feliksdd/panellog/hardware/kicad/ERC_DRC_REVIEW_2026-10-29_2241.md

# PanelLog: KiCad 10 ERC/DRC follow-up — 2026-10-29 22:41

## Source reports

- Uploaded `panellog-erc-aktuell.rpt` (2026-10-29T22:41:49): **0 errors, 3 warnings** of type `same_local_global_label`. Flags added in the previous commit had been connected with local labels `VDC`, `GND` and `+3V3`, which KiCad flags because those are already implicit global power-symbol nets.
- Uploaded `panellog-pcb-drc-aktuell.rpt` (2026-10-29T22:41:55): **39 DRC footprint-library warnings**, **131 unrouted pads/connections**, **2 PCB/schematic field differences**. Crucially, **0 reported `shorting_items`, 0 `solder_mask_bridge`, and 0 `net_conflict`**. This is a significant improvement compared with the previous DRC, which had 7+7+6 violations respectively.

These counts describe the attached **pre-fix** reports, NOT a native KiCad run after the changes below.

## Corrections made for this report

1. Removed three redundant local labels at the Power Flag block (VDC/GND/+3V3).
2. Added **actual KiCad `power:VDC`, `power:GND`, `power:+3V3` symbol instances**, references `#PWR036`–`#PWR038`, each connected with a short straight `wire` to the existing `power:PWR_FLAG` instance. The power symbols' global connectivity is explicit, rather than relying on a local net label matching a global power symbol. Neither board components nor circuit topology change.
3. Fixed two PCB footprint metadata mismatches: RSH1 Datasheet now equals the schematic's Isabellenhütte BVB URL and Y1 Description now equals the schematic field "Two pin crystal". Do not treat PCB metadata synchronization as footprint-geometry verification.

## Remaining work

### 39 `lib_footprint_mismatch` warnings

The board's 39 footprint *instances* differ from their linked KiCad/PanelLog library copies. Most were generated in the placement draft and use approximated artwork/courtyard/pad and assembly information. **Do not disable this check to pass DRC.** For standard, manufacturer-qualified resistor/capacitor/diode/SOT-23/crystal footprints, use KiCad 10 PCB editor → **Tools → Update Footprints from Library…** selectively, reviewing rotations, pads and existing net assignments. For project-specific `*_DRAFT` footprints (BVB Kelvin, Infineon TOLL, E73, LM5164 DDA, provisional L1/MC4), first validate the manufacturer's physical land-pattern, paste, mask, pad numbering and RF/mechanical keepouts; only then synchronize the schematic and board.

### 131 unconnected items

The board is *almost entirely unrouted*, so these messages are expected but represent real electrical incompleteness. The 9-mm PV+ and 5-mm SHUNT_RETURN study segments have not been validated for 20 A, no full low-side return or Kelvin routing exists, and there is no valid RF copper keepout. Complete the placement/footprints and current paths before attempting other routing or Gerber fabrication.

### Native checks to run again

```bash
git pull --ff-only
flatpak run --command=kicad-cli org.kicad.KiCad sch erc \
  hardware/kicad/panellog.kicad_sch -o panellog-erc-next.rpt
flatpak run --command=kicad-cli org.kicad.KiCad pcb drc \
  --schematic-parity --severity-all \
  -o panellog-pcb-drc-next.rpt hardware/kicad/panellog.kicad_pcb
```

Expected outcome of the next run: the three duplicate-label ERC warnings and two PCB field mismatches should be gone; 39 library mismatch messages and the unrouted connections will persist until explicitly resolved. If any newly introduced ERC or DRC issue appears, analyze the concrete report rather than suppress it.

**Release status remains: NOT FOR FABRICATION.**
