feliksdd/panellog/hardware/kicad/review_2026-11-04/back.png

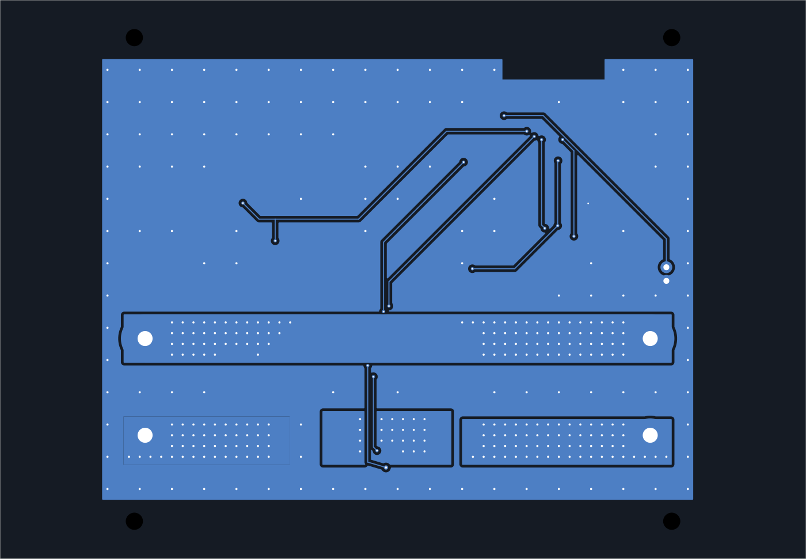
hardware/kicad/review_2026-11-04/back.png
