feliksdd/panellog/hardware/kicad/review_2026-11-04/front.png

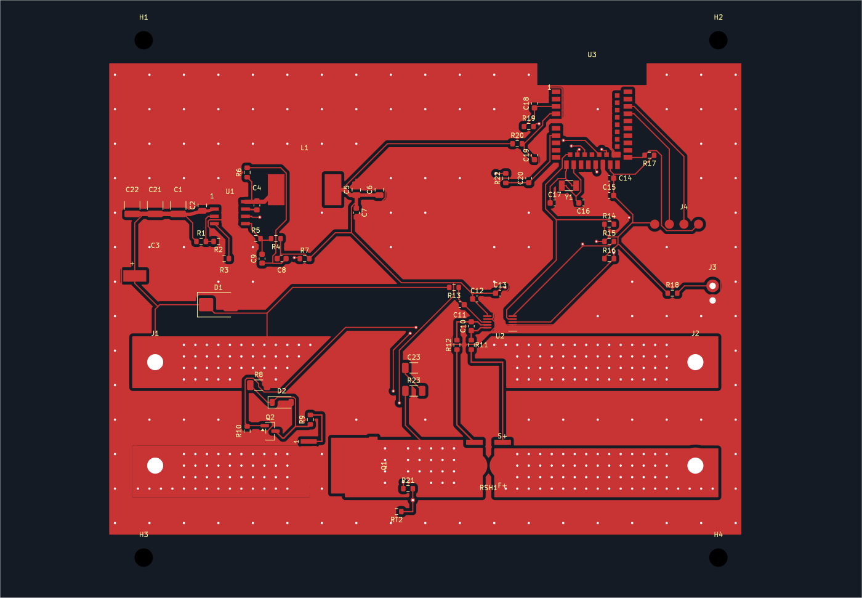
hardware/kicad/review_2026-11-04/front.png
