feliksdd/panellog/docs/bom_costs_2026-11-08.md

# PanelLog BOM availability and cost audit — 2026-11-08

Based on GitHub a25bd26 plus Sumida L1 replacement. Public LCSC USD catalogue
prices and stock were retrieved directly from product-page structured data.
Per-part quantities, MOQ, order multiple, price tiers, stock, timestamp and URL
are saved in bom/panellog_costs_2026-11-08.csv and lcsc_audit_2026-11-08.json.

## Result

59 fitted PCB components, 33 distinct PCB order codes; external Pt1000 adds
one part and one code. All purchased, selected components now have an exact
LCSC number. 32 of 33 PCB order codes and the external sensor are in stock
in quantities sufficient for four boards and their MOQ. **R18 remains out of
stock. A complete orderable final BOM price cannot yet be confirmed.**

| Scope | Fitted parts, one-board batch | Fitted parts, four-board batch | Purchase incl. MOQ, one board | Purchase incl. MOQ, four boards |
|---|---:|---:|---:|---:|
| PCB components incl. R18 reference price | $14.3677 | $56.3860 ($14.0965/board) | $26.4805 | $65.2717 |
| External bare Pt1000 | $2.6957 | $10.7828 | $2.6957 | $10.7828 |
| Combined, incl. unavailable R18 reference price | $17.0634 | $67.1688 | $29.1762 | $76.0545 |

These totals exclude PCB fabrication, assembly, component attrition,
shipping, taxes, customs, enclosure, cables and sealing. MOQ calculations
use the catalogue minimum and order multiple, NOT the full-reel quantity.
The first available price tier is used below MOQ for fitted-cost allocation.
Four-board demand is aggregated across identical order codes before pricing.
Stocked items only cost $64.2821 for PCB parts, or $75.0649 including four bare
Pt1000 elements. **These subtotals omit R18 and are not a complete BOM.**
No order was placed. Checkout rounding and stock/price changes can alter totals.

## Changes and sourcing gaps

- L1: CDRH127/LDNP-680MC, C2452974, stock 5,871, $0.7122 at quantity 1–9.
  Schematic, footprint and board updated; see sumida_l1_2026-11-08.md.
- C7/C10/C12/C14/C18/C19/C20/C25: C14663 has stock zero. Replaced with
  Samsung CL10B104KB8NNNC, C1591: same 100 nF, 50 V, X7R, ±10%, 0603.
  Stock 1,668,800, MOQ/multiple 100, $0.0072 at 100. Eight fitted per board.
- RT1: exact bare YAGEO/Nexensos 32208572 = C17472362, stock 214,
  $2.6957 each. This is NOT a weatherproof cabled probe. Manufacturer lifecycle
  information marks it not for new design; existing design retained.
- R18: RG1608N-1472-W-T1, C1721340, stock zero. Listed $0.2474 is a
  reference price only. Checked W-T5, P-W-T1 and N-B-T5 variants also lack stock.
  C2074591 (Panasonic ERA-3AEB1472V) has stock 925, MOQ 5, $0.0804 each,
  but is ±0.1% / ±25 ppm/K instead of ±0.05% / ±10 ppm/K. Same resistance and
  0603 footprint, but **not substituted**. Approximate extra Pt1000 reference
  error at 25 °C: 0.13 K initial and 0.195 K after a 50 K board temperature
  change (first-order 3850 ppm/K model); calibration can remove initial ratio
  error, not uncharacterized temperature drift. If approved, the four-board
  purchase total including sensor would be $75.4669, still excluding mechanics.

## Non-purchased PCB features and external assembly

J1 is absent from the current design and marked removed. Current power pads
are J2/J6 (VDC), J5 (MPPT_MINUS), J7 (GND). J3 is the sensor cable solder pad;
J4 consists of programming pogo lands. H1–H4 are drilled mounting holes.
They have no separate LCSC order number and zero purchased-component quantity.
Do not buy four fictitious connector bodies from these PCB references.

External PV leads, compatible connector pairs, sensor cable/encapsulation,
cable glands, enclosure and spacers remain mechanically unspecified. No
arbitrary LCSC part is assigned without wire size, cable length, mating system
and enclosure interface. Their cost is **not included and not finalized**.
C16/C17/Y1 are removed; C23/D1/R23 are DNP and excluded. DNP snubber/TVS values
must follow transient qualification rather than being selected to fill a BOM cell.

## Deliverables and checks

- panellog_rev0_selection.csv: one line per reference, including explicit
  non-orderable PCB features, DNP and removed references.
- panellog_c6_procurement_4boards.csv: consolidated selected component demand,
  including RT1 and the blocked R18.
- LCSC_import_4boards_in_stock.csv: MOQ-rounded import for stocked lines only.
  **R18 intentionally missing; this import does not complete four boards.**
- panellog_costs_2026-11-08.csv: full costing and availability, USD.

Native KiCad final checks: 43 existing open connections, zero parity issues,
five existing ERC findings. No new electrical DRC errors. Not ready for manufacture.
