feliksdd/panellog/bom/panellog_c6_procurement_4boards.csv

References | Value | MPN | LCSC | Footprint | Qty_per_board | Qty_4_boards
C1 C21 C22 | 4.7uF 100V X7R | 1210B475K101NT | C7500895 | Capacitor_SMD:C_1210_3225Metric | 3 | 12
C2 | 100nF 100V X7R | CL21B104KCFNNNE | C28233 | Capacitor_SMD:C_0805_2012Metric | 1 | 4
C3 | 10uF 100V EEEFN2A100P | EEEFN2A100P | C494873 | PanelLog:Panasonic_F_8x10p2 | 1 | 4
C4 | 2.2nF 50V X7R | 0603B222K500NT | C1604 | Capacitor_SMD:C_0603_1608Metric | 1 | 4
C5 C6 C15 | 22uF 25V X5R | CL21A226MAQNNNE | C45783 | Capacitor_SMD:C_0805_2012Metric | 3 | 12
C7 C10 C12 C14 C18 C19 C20 C25 | 100nF 50V X7R | CC0603KRX7R9BB104 | C14663 | Capacitor_SMD:C_0603_1608Metric | 8 | 32
C8 | 3.3nF 50V X7R | CL10B332KB8NNNC | C1613 | Capacitor_SMD:C_0603_1608Metric | 1 | 4
C9 | 150pF 50V C0G | CL10C151JB8NNNC | C37298 | Capacitor_SMD:C_0603_1608Metric | 1 | 4
C11 | 10nF 100V X7R | CC0603KRX7R0BB103 | C107059 | Capacitor_SMD:C_0603_1608Metric | 1 | 4
C13 C24 | 1uF 50V X5R | CL10A105KB8NNNC | C15849 | Capacitor_SMD:C_0603_1608Metric | 2 | 8
D2 | MMSZ4697 10V C2910058 | MMSZ4697 | C2910058 | Diode_SMD:D_SOD-123 | 1 | 4
L1 | 68uH CDRH127/LDNP-680MC | CDRH127/LDNP-680MC | C2452974 | PanelLog:Sumida_CDRH127_LD_68uH | 1 | 4
Q1 | IPT015N10N5 | IPT015N10N5 | C108964 | PanelLog:IPT015N10N5_TOLL | 1 | 4
Q2 | 2N7002 | 2N7002 | C8545 | Package_TO_SOT_SMD:SOT-23 | 1 | 4
R1 | 1M 1% | 0603WAF1004T5E | C22935 | Resistor_SMD:R_0603_1608Metric | 1 | 4
R2 | 200k 1% | 0603WAF2003T5E | C25811 | Resistor_SMD:R_0603_1608Metric | 1 | 4
R3 R29 | 27.4k 1% | 0603WAF2742T5E | C22964 | Resistor_SMD:R_0603_1608Metric | 2 | 8
R4 | 174k 1% | 0603WAF1743T5E | C22890 | Resistor_SMD:R_0603_1608Metric | 1 | 4
R5 R10 R20 R24 | 100k 1% | 0603WAF1003T5E | C25803 | Resistor_SMD:R_0603_1608Metric | 4 | 16
R6 | 150k 1% | 0603WAF1503T5E | C22807 | Resistor_SMD:R_0603_1608Metric | 1 | 4
R7 | 47k 1% | 0603WAF4702T5E | C25819 | Resistor_SMD:R_0603_1608Metric | 1 | 4
R8 | 47k 1% 0.25W | SCR1206F47K | C5140109 | Resistor_SMD:R_1206_3216Metric | 1 | 4
R9 | 2.2k 1% | 0603WAF2201T5E | C4190 | Resistor_SMD:R_0603_1608Metric | 1 | 4
R11 R12 R13 | 10R 1% | 0603WAF100JT5E | C22859 | Resistor_SMD:R_0603_1608Metric | 3 | 12
R14 R15 R16 R17 R21 R25 R26 | 10k 1% | 0603WAF1002T5E | C25804 | Resistor_SMD:R_0603_1608Metric | 7 | 28
R18 | 14.7k 0.05% 10ppm/K | RG1608N-1472-W-T1 | C1721340 | Resistor_SMD:R_0603_1608Metric | 1 | 4
R19 R22 | 1k 1% | 0603WAF1001T5E | C21190 | Resistor_SMD:R_0603_1608Metric | 2 | 8
RSH1 | HOVB4026-5W-1mR-1% | HOVB4026-5W-1mR-1% | C481535 | PanelLog:HOVB4026_R001_Kelvin | 1 | 4
RT1 | M222 Pt1000 Class A external probe | 32208572 | C17472362 |  | 1 | 4
RT2 | 10k NTC near Q1 | NTCG163JF103FT1S | C406719 | Resistor_SMD:R_0603_1608Metric | 1 | 4
U1 | LM5163DDAR | LM5163DDAR | C2873264 | PanelLog:LM5164_DDA | 1 | 4
U2 | INA237AIDGSR | INA237AIDGSR | C2864837 | PanelLog:INA237_DGS10 | 1 | 4
U3 | ESP32-C6-MINI-1-N4 | ESP32-C6-MINI-1-N4 | C5736265 | PanelLog:ESP32_C6_MINI_1 | 1 | 4
R27 R28 | 1M 1% | 1206W4F1004T5E | C17927 | Resistor_SMD:R_1206_3216Metric | 2 | 8
