feliksdd/panellog/bom/panellog_rev0_selection.csv

Ref | Value | Footprint | MPN_or_candidate | LCSC | Disposition | Selection_notes
C1 | 4.7uF 100V X7R | Capacitor_SMD:C_1210_3225Metric | 1210B475K101NT | C7500895 | SELECTED_PROTOTYPE | C6 cost revision; qualification requirements in docs/c6_cost_revision_2026-11-06.md
C2 | 100nF 100V X7R | Capacitor_SMD:C_0805_2012Metric | CL21B104KCFNNNE | C28233 | SELECTED_PROTOTYPE | C6 cost revision; qualification requirements in docs/c6_cost_revision_2026-11-06.md
C3 | 10uF 100V EEEFN2A100P | PanelLog:Panasonic_F_8x10p2 | Panasonic EEEFN2A100P | C494873 | CANDIDATE_REVIEW | Polarized symbol and Panasonic F 8x10.2 land pattern corrected; lifetime/ESR suitability still requires verification.
C4 | 2.2nF 50V X7R | Capacitor_SMD:C_0603_1608Metric | 0603B222K500NT | C1604 | SELECTED_PROTOTYPE | User-selected LCSC substitution 2026-11-09; synchronized with native schematic.
C5 | 22uF 25V X5R | Capacitor_SMD:C_0805_2012Metric | GRM21BR61E226ME44L | C86816 | SELECTED_PROTOTYPE | Selected replacement 2026-11-09; retain package; R18 gain calibration required.
C6 | 22uF 25V X5R | Capacitor_SMD:C_0805_2012Metric | GRM21BR61E226ME44L | C86816 | SELECTED_PROTOTYPE | Selected replacement 2026-11-09; retain package; R18 gain calibration required.
C7 | 100nF 50V X7R | Capacitor_SMD:C_0603_1608Metric | CC0603KRX7R9BB104 | C14663 | SELECTED_PROTOTYPE | User-selected LCSC substitution 2026-11-09; synchronized with native schematic.
C8 | 3.3nF 50V X7R | Capacitor_SMD:C_0603_1608Metric | CL10B332KB8NNNC | C1613 | SELECTED_PROTOTYPE | C6 cost revision; qualification requirements in docs/c6_cost_revision_2026-11-06.md
C9 | 150pF 50V C0G | Capacitor_SMD:C_0603_1608Metric | CL10C151JB8NNNC | C37298 | SELECTED_PROTOTYPE | C6 cost revision; qualification requirements in docs/c6_cost_revision_2026-11-06.md
C10 | 100nF 50V X7R | Capacitor_SMD:C_0603_1608Metric | CC0603KRX7R9BB104 | C14663 | SELECTED_PROTOTYPE | User-selected LCSC substitution 2026-11-09; synchronized with native schematic.
C11 | 10nF 100V X7R | Capacitor_SMD:C_0603_1608Metric | CC0603KRX7R0BB103 | C107059 | SELECTED_PROTOTYPE | C6 cost revision; qualification requirements in docs/c6_cost_revision_2026-11-06.md
C12 | 100nF 50V X7R | Capacitor_SMD:C_0603_1608Metric | CC0603KRX7R9BB104 | C14663 | SELECTED_PROTOTYPE | User-selected LCSC substitution 2026-11-09; synchronized with native schematic.
C13 | 1uF 50V X5R | Capacitor_SMD:C_0603_1608Metric | CL10A105KB8NNNC | C15849 | SELECTED_PROTOTYPE | User-selected LCSC substitution 2026-11-09; synchronized with native schematic.
C14 | 100nF 50V X7R | Capacitor_SMD:C_0603_1608Metric | CC0603KRX7R9BB104 | C14663 | SELECTED_PROTOTYPE | User-selected LCSC substitution 2026-11-09; synchronized with native schematic.
C15 | 22uF 25V X5R | Capacitor_SMD:C_0805_2012Metric | GRM21BR61E226ME44L | C86816 | SELECTED_PROTOTYPE | Selected replacement 2026-11-09; retain package; R18 gain calibration required.
C16 | 22pF C0G | Capacitor_SMD:C_0603_1608Metric |  |  | REMOVED | C6 module uses internal LP clock; no external 32 kHz crystal.
C17 | 22pF C0G | Capacitor_SMD:C_0603_1608Metric |  |  | REMOVED | C6 module uses internal LP clock; no external 32 kHz crystal.
C18 | 100nF 50V X7R | Capacitor_SMD:C_0603_1608Metric | CC0603KRX7R9BB104 | C14663 | SELECTED_PROTOTYPE | User-selected LCSC substitution 2026-11-09; synchronized with native schematic.
C19 | 100nF 50V X7R | Capacitor_SMD:C_0603_1608Metric | CC0603KRX7R9BB104 | C14663 | SELECTED_PROTOTYPE | User-selected LCSC substitution 2026-11-09; synchronized with native schematic.
C20 | 100nF 50V X7R | Capacitor_SMD:C_0603_1608Metric | CC0603KRX7R9BB104 | C14663 | SELECTED_PROTOTYPE | User-selected LCSC substitution 2026-11-09; synchronized with native schematic.
C21 | 4.7uF 100V X7R | Capacitor_SMD:C_1210_3225Metric | 1210B475K101NT | C7500895 | SELECTED_PROTOTYPE | C6 cost revision; qualification requirements in docs/c6_cost_revision_2026-11-06.md
C22 | 4.7uF 100V X7R | Capacitor_SMD:C_1210_3225Metric | 1210B475K101NT | C7500895 | SELECTED_PROTOTYPE | C6 cost revision; qualification requirements in docs/c6_cost_revision_2026-11-06.md
C23 | DNP 10nF 200V TBD | Capacitor_SMD:C_1206_3216Metric |  |  | DNP | Optional RC snubber capacitor; 200V rating desired, not selected.
D1 | DNP TVS - select after cold-Voc/transient validation | Diode_SMD:D_SMB |  |  | DNP | PV+ TVS deliberately not installed; choose only after measured overvoltages.
D2 | MMSZ4697 10V C2910058 | Diode_SMD:D_SOD-123 | JSCJ MMSZ4697 | C2910058 | SELECTED_PROTOTYPE | 10V Zener at 50uA nominal: hot leakage and actual Q1 VGS must be tested.
J1 | PV MODULE IN / PV-rated pigtail | PanelLog:PV_MC4_Pigtail_2x2p8_DRAFT | MC4 PV-rated cable assemblies |  | REMOVED | Not present in current schematic/PCB. Power solder pads are J2 J5 J6 J7.
J2 | MPPT OUT / PV-rated pigtail | PanelLog:PV_MC4_Pigtail_2x2p8_DRAFT | PCB feature, no LCSC ordering number applicable |  | PCB_FEATURE | PCB solder/pogo lands, no purchased connector. External cables/fixture are separate assembly items.
J3 | External Pt1000 probe | PanelLog:Pt1000_Cable_2pin_DRAFT | PCB feature, no LCSC ordering number applicable |  | PCB_FEATURE | PCB solder/pogo lands, no purchased connector. External cables/fixture are separate assembly items.
J4 | UART / BOOT pogo | PanelLog:UART_BOOT_1x06_Pogo | PCB feature, no LCSC ordering number applicable |  | PCB_FEATURE | PCB solder/pogo lands, no purchased connector. External cables/fixture are separate assembly items.
L1 | 68uH CDRH127/LDNP-680MC | PanelLog:Sumida_CDRH127_LD_68uH | CDRH127/LDNP-680MC | C2452974 | SELECTED_PROTOTYPE | Sumida selected 2026-11-08; OEM keepout added. See docs/sumida_l1_2026-11-08.md. Max component temperature 100C.
Q1 | IPT015N10N5 | PanelLog:IPT015N10N5_TOLL | Infineon IPT015N10N5ATMA1 | C108964 | SELECTED_PROTOTYPE | OEM PG-HSOF-8 land geometry; pad 1 gate, 2-8 source, 9 drain. 20A thermal validation pending.
Q2 | 2N7002 | Package_TO_SOT_SMD:SOT-23 | 2N7002 | C8545 | CANDIDATE_REVIEW | User-selected LCSC substitution 2026-11-09; synchronized with native schematic. Gate-control path still requires qualification at 3.3V and over temperature.
R1 | 1M 1% | Resistor_SMD:R_0603_1608Metric | 0603WAF1004T5E | C22935 | SELECTED_PROTOTYPE | C6 cost revision; qualification requirements in docs/c6_cost_revision_2026-11-06.md
R2 | 200k 1% | Resistor_SMD:R_0603_1608Metric | 0603WAF2003T5E | C25811 | SELECTED_PROTOTYPE | C6 cost revision; qualification requirements in docs/c6_cost_revision_2026-11-06.md
R3 | 27.4k 1% | Resistor_SMD:R_0603_1608Metric | 0603WAF2742T5E | C22964 | SELECTED_PROTOTYPE | C6 cost revision; qualification requirements in docs/c6_cost_revision_2026-11-06.md
R4 | 174k 1% | Resistor_SMD:R_0603_1608Metric | 0603WAF1743T5E | C22890 | SELECTED_PROTOTYPE | C6 cost revision; qualification requirements in docs/c6_cost_revision_2026-11-06.md
R5 | 100k 1% | Resistor_SMD:R_0603_1608Metric | 0603WAF1003T5E | C25803 | SELECTED_PROTOTYPE | C6 cost revision; qualification requirements in docs/c6_cost_revision_2026-11-06.md
R6 | 150k 1% | Resistor_SMD:R_0603_1608Metric | 0603WAF1503T5E | C22807 | SELECTED_PROTOTYPE | C6 cost revision; qualification requirements in docs/c6_cost_revision_2026-11-06.md
R7 | 47k 1% | Resistor_SMD:R_0603_1608Metric | 0603WAF4702T5E | C25819 | SELECTED_PROTOTYPE | C6 cost revision; qualification requirements in docs/c6_cost_revision_2026-11-06.md
R8 | 47k 1% 0.25W | Resistor_SMD:R_1206_3216Metric | VO SCR1206F47K | C5140109 | SELECTED_PROTOTYPE | 47kohm 1% 1206 250mW 200V; 77.4mW at 60V with Q2 on and minimum resistance at 25C. Verify hot derating and zener knee; see docs/cost_followup_2026-11-06.md.
R9 | 2.2k 1% | Resistor_SMD:R_0603_1608Metric | 0603WAF2201T5E | C4190 | SELECTED_PROTOTYPE | C6 cost revision; qualification requirements in docs/c6_cost_revision_2026-11-06.md
R10 | 100k 1% | Resistor_SMD:R_0603_1608Metric | 0603WAF1003T5E | C25803 | SELECTED_PROTOTYPE | C6 cost revision; qualification requirements in docs/c6_cost_revision_2026-11-06.md
R11 | 10R 1% | Resistor_SMD:R_0603_1608Metric | 0603WAF100JT5E | C22859 | SELECTED_PROTOTYPE | C6 cost revision; qualification requirements in docs/c6_cost_revision_2026-11-06.md
R12 | 10R 1% | Resistor_SMD:R_0603_1608Metric | 0603WAF100JT5E | C22859 | SELECTED_PROTOTYPE | C6 cost revision; qualification requirements in docs/c6_cost_revision_2026-11-06.md
R13 | 10R 1% | Resistor_SMD:R_0603_1608Metric | 0603WAF100JT5E | C22859 | SELECTED_PROTOTYPE | C6 cost revision; qualification requirements in docs/c6_cost_revision_2026-11-06.md
R14 | 10k 1% | Resistor_SMD:R_0603_1608Metric | 0603WAF1002T5E | C25804 | SELECTED_PROTOTYPE | C6 cost revision; qualification requirements in docs/c6_cost_revision_2026-11-06.md
R15 | 10k 1% | Resistor_SMD:R_0603_1608Metric | 0603WAF1002T5E | C25804 | SELECTED_PROTOTYPE | C6 cost revision; qualification requirements in docs/c6_cost_revision_2026-11-06.md
R16 | 10k 1% | Resistor_SMD:R_0603_1608Metric | 0603WAF1002T5E | C25804 | SELECTED_PROTOTYPE | C6 cost revision; qualification requirements in docs/c6_cost_revision_2026-11-06.md
R17 | 10k 1% | Resistor_SMD:R_0603_1608Metric | 0603WAF1002T5E | C25804 | SELECTED_PROTOTYPE | C6 cost revision; qualification requirements in docs/c6_cost_revision_2026-11-06.md
R18 | 14.7k 0.1% 10ppm/K | Resistor_SMD:R_0603_1608Metric | PTFR0603B14K7N9 | C19680002 | SELECTED_PROTOTYPE | Selected replacement 2026-11-09; retain package; R18 gain calibration required.
R19 | 1k 1% | Resistor_SMD:R_0603_1608Metric | 0603WAF1001T5E | C21190 | SELECTED_PROTOTYPE | C6 cost revision; qualification requirements in docs/c6_cost_revision_2026-11-06.md
R20 | 100k 1% | Resistor_SMD:R_0603_1608Metric | 0603WAF1003T5E | C25803 | SELECTED_PROTOTYPE | C6 cost revision; qualification requirements in docs/c6_cost_revision_2026-11-06.md
R21 | 10k 1% | Resistor_SMD:R_0603_1608Metric | 0603WAF1002T5E | C25804 | SELECTED_PROTOTYPE | C6 cost revision; qualification requirements in docs/c6_cost_revision_2026-11-06.md
R22 | 1k 1% | Resistor_SMD:R_0603_1608Metric | 0603WAF1001T5E | C21190 | SELECTED_PROTOTYPE | C6 cost revision; qualification requirements in docs/c6_cost_revision_2026-11-06.md
R23 | DNP 10R snubber TBD | Resistor_SMD:R_1206_3216Metric |  |  | DNP | Optional RC snubber resistor; first capture Q1 switching transient.
RSH1 | HOVB4026-5W-1mR-1% | PanelLog:HOVB4026_R001_Kelvin | Milliohm HOVB4026-5W-1mR-1% | C481535 | SELECTED_PROTOTYPE | HoVB A0 p6 four-terminal land pattern; 1mOhm 5W 1% 50ppm/K; calibrate zero and gain.
RT1 | M222 Pt1000 Class A external probe |  | Nexensos M222 Pt1000 F0.15 Class A 32208572 | C17472362 | EXTERNAL_SENSOR | Exact 32208572 bare Pt1000 element; cable and weatherproof encapsulation not included. Check lifecycle (manufacturer marks not for new design).
RT2 | 10k NTC near Q1 | Resistor_SMD:R_0603_1608Metric | TDK NTCG163JF103FT1S | C406719 | CANDIDATE_REVIEW | 10kohm@25C, B25/50 3380K typical; B25/85 3435K +-1%, 0603; ADC calibration beta and thermal coupling.
U1 | LM5163DDAR | PanelLog:LM5164_DDA | LM5163DDAR | C2873264 | SELECTED_PROTOTYPE | C6 cost revision; qualification requirements in docs/c6_cost_revision_2026-11-06.md
U2 | INA237AIDGSR | PanelLog:INA237_DGS10 | TI INA237AIDGSR | C2864837 | SELECTED_PROTOTYPE | DGS10 pin-compatible; 16-bit registers; ADCRANGE=1; MCU energy integration required.
U3 | ESP32-C6-MINI-1-N4 | PanelLog:ESP32_C6_MINI_1 | ESP32-C6-MINI-1-N4 | C5736265 | SELECTED_PROTOTYPE | C6 cost revision; qualification requirements in docs/c6_cost_revision_2026-11-06.md
Y1 | 32.768kHz CL=12.5pF | Crystal:Crystal_SMD_3215-2Pin_3.2x1.5mm | Jauch Q 0,032768-JTX310-12,5-10-T1-HMR-LF | C5848533 | REMOVED | C6 module uses internal LP clock; no external 32 kHz crystal.
R24 | 100k 1% | Resistor_SMD:R_0603_1608Metric | 0603WAF1003T5E | C25803 | SELECTED_PROTOTYPE | C6 ADC divider / bootstrap / reset network
R25 | 10k 1% | Resistor_SMD:R_0603_1608Metric | 0603WAF1002T5E | C25804 | SELECTED_PROTOTYPE | C6 ADC divider / bootstrap / reset network
R26 | 10k 1% | Resistor_SMD:R_0603_1608Metric | 0603WAF1002T5E | C25804 | SELECTED_PROTOTYPE | C6 ADC divider / bootstrap / reset network
C24 | 1uF 50V X5R | Capacitor_SMD:C_0603_1608Metric | CL10A105KB8NNNC | C15849 | SELECTED_PROTOTYPE | User-selected LCSC substitution 2026-11-09; synchronized with native schematic.
R27 | 1M 1% | Resistor_SMD:R_1206_3216Metric | 1206W4F1004T5E | C17927 | SELECTED | Shutdown diagnostic; see docs/shutdown_feedback.md
R28 | 1M 1% | Resistor_SMD:R_1206_3216Metric | 1206W4F1004T5E | C17927 | SELECTED | Shutdown diagnostic; see docs/shutdown_feedback.md
R29 | 27.4k 1% | Resistor_SMD:R_0603_1608Metric | 0603WAF2742T5E | C22964 | SELECTED | Shutdown diagnostic; see docs/shutdown_feedback.md
C25 | 100nF 50V X7R | Capacitor_SMD:C_0603_1608Metric | CC0603KRX7R9BB104 | C14663 | SELECTED | User-selected LCSC substitution 2026-11-09; synchronized with native schematic.
J5 | Power cable solder pad MPPT_MINUS | PanelLog:PV_MC4_Pigtail_2x2p8_DRAFT | PCB feature, no LCSC ordering number applicable |  | PCB_FEATURE | Separate external PV-rated wire, compatible connectors and strain relief must be specified.
J6 | Power cable solder pad VDC | PanelLog:PV_MC4_Pigtail_2x2p8_DRAFT | PCB feature, no LCSC ordering number applicable |  | PCB_FEATURE | Separate external PV-rated wire, compatible connectors and strain relief must be specified.
J7 | Power cable solder pad GND | PanelLog:PV_MC4_Pigtail_2x2p8_DRAFT | PCB feature, no LCSC ordering number applicable |  | PCB_FEATURE | Separate external PV-rated wire, compatible connectors and strain relief must be specified.
H1 | 3.2mm mounting hole | PanelLog:MountingHole_3p2_Nylon | PCB feature, no LCSC ordering number applicable |  | PCB_FEATURE | Fasteners/spacers belong to the separately specified enclosure assembly.
H2 | 3.2mm mounting hole | PanelLog:MountingHole_3p2_Nylon | PCB feature, no LCSC ordering number applicable |  | PCB_FEATURE | Fasteners/spacers belong to the separately specified enclosure assembly.
H3 | 3.2mm mounting hole | PanelLog:MountingHole_3p2_Nylon | PCB feature, no LCSC ordering number applicable |  | PCB_FEATURE | Fasteners/spacers belong to the separately specified enclosure assembly.
H4 | 3.2mm mounting hole | PanelLog:MountingHole_3p2_Nylon | PCB feature, no LCSC ordering number applicable |  | PCB_FEATURE | Fasteners/spacers belong to the separately specified enclosure assembly.
C26 | 100nF 50V X7R | Capacitor_SMD:C_0603_1608Metric | CL10B104KB8NNNC | C1591 | DNP_BUFFER_OPTION | Populate together with U4 P82B715; local VCC bypass.
