feliksdd/panellog/hardware/3dmodels/assembly/PanelLog_in_Spelsberg_ENVELOPE.step

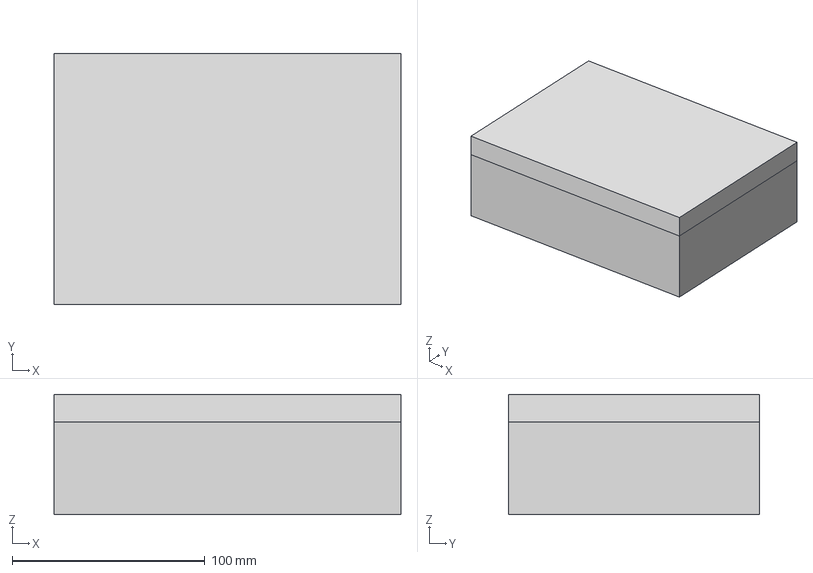
[picture p3: CAD file, 2026-11-03]
hardware/3dmodels/assembly/PanelLog_in_Spelsberg_ENVELOPE.step
180.0 x 130.0 x 62.5 mm
PCB_populated
BASE_simplified
LID_simplified
