feliksdd/panellog/hardware/3dmodels/generated/Crystal_3215_ENVELOPE.step

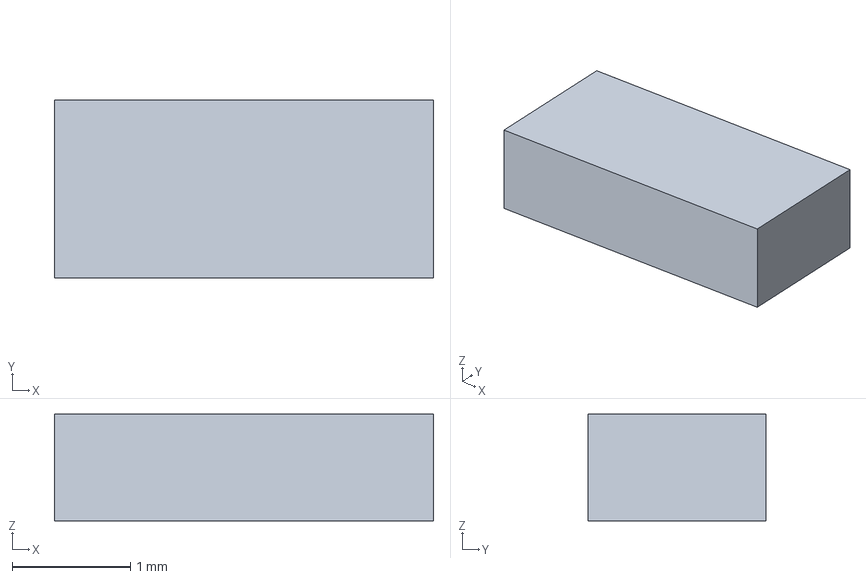
[picture p4: CAD file, 2026-11-03]
hardware/3dmodels/generated/Crystal_3215_ENVELOPE.step
3.20 x 1.50 x 0.9 mm
