feliksdd/panellog/hardware/3dmodels/manufacturer/ESP32-C6-WROOM.step

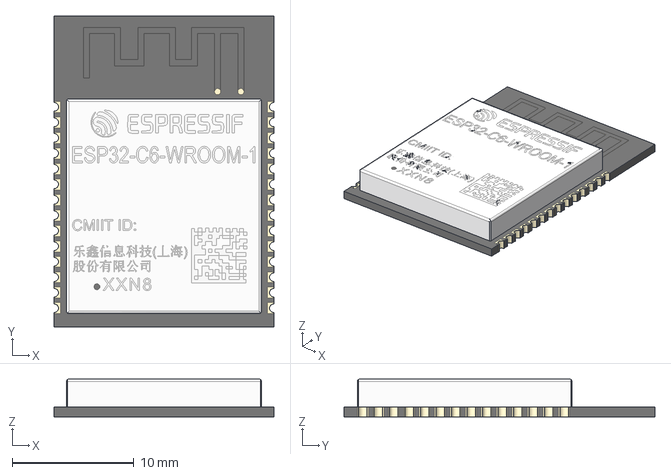
[picture p5: CAD file, 2026-11-10]
hardware/3dmodels/manufacturer/ESP32-C6-WROOM.step
18.0 x 25.5 x 3.11 mm
