feliksdd/panellog/hardware/3dmodels/generated/IPT015N10N5_ENVELOPE.step

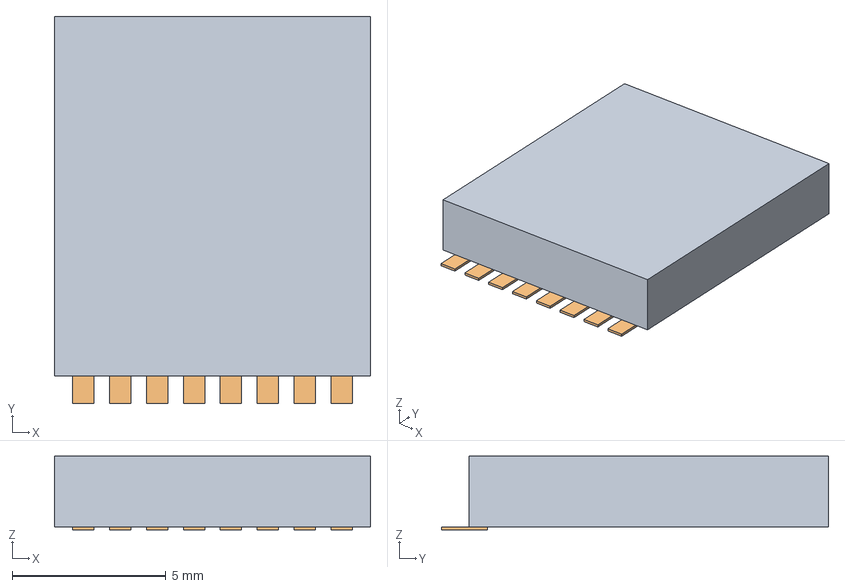
[picture p6: CAD file, 2026-11-03]
hardware/3dmodels/generated/IPT015N10N5_ENVELOPE.step
10.3 x 12.6 x 2.40 mm
