feliksdd/panellog/hardware/3dmodels/manufacturer/BVB-M-R0007.STEP

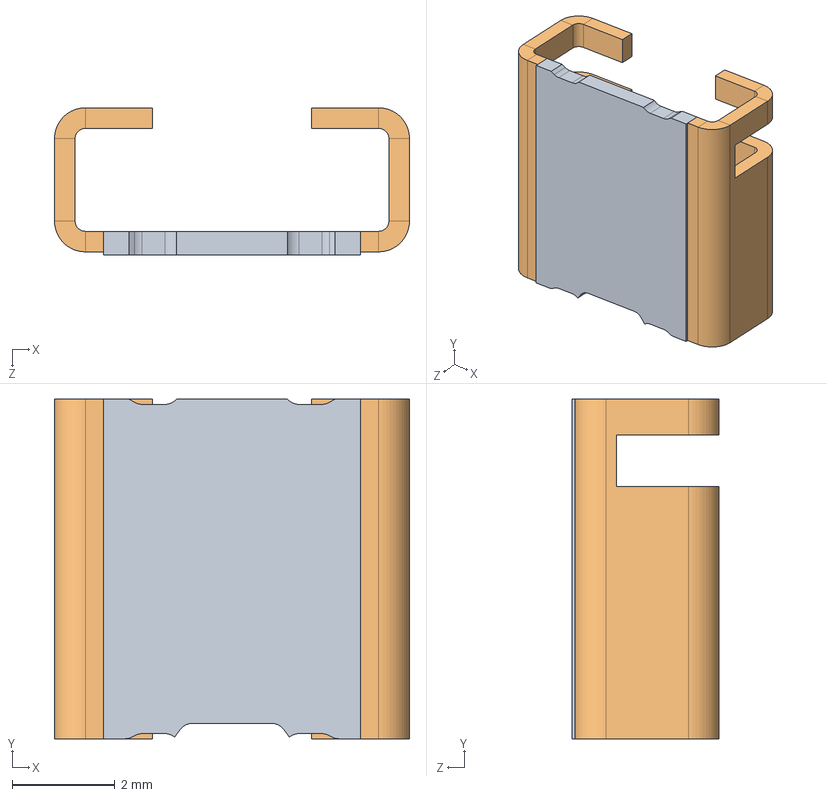
[picture p7: CAD file, 2026-11-06]
hardware/3dmodels/manufacturer/BVB-M-R0007.STEP
6.90 x 6.60 x 2.87 mm
Widerstand BVB-Z-R0007 - 01 - Z-YH-978_BVB-V-R002
Widerstand BVB-Z-R0007 - 02 - Z-YH-978_BVB-V-R002
Widerstand BVB-Z-R0007 - 03 - Z-YH-978_BVB-V-R002
