feliksdd/panellog/hardware/mechanical/Z74_base_reference.dxf

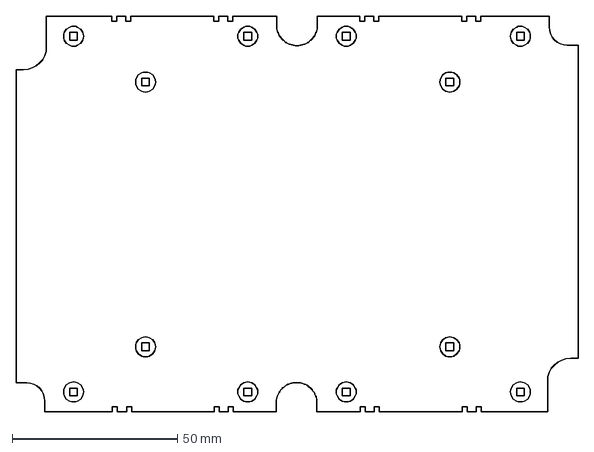
[picture p8: CAD file, 2026-11-05]
hardware/mechanical/Z74_base_reference.dxf
170.0 x 119.7 mm
