feliksdd/panellog/hardware/3dmodels/generated/PV_SOLDER_WIRES_ENVELOPE.step

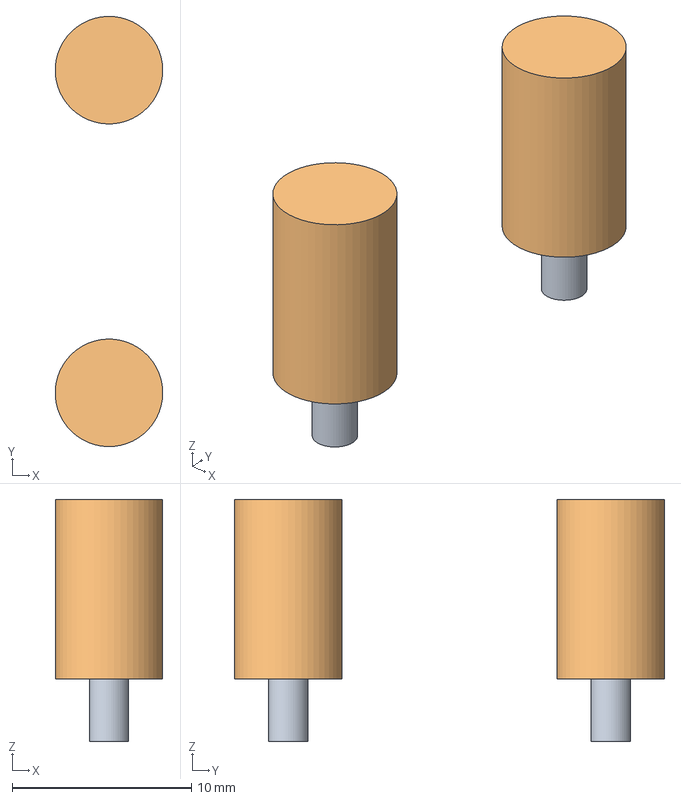
[picture p9: CAD file, 2026-11-03]
hardware/3dmodels/generated/PV_SOLDER_WIRES_ENVELOPE.step
5.99 x 24.0 x 13.5 mm
