feliksdd/panellog/hardware/3dmodels/manufacturer/BVB-M-R001-1.0.step

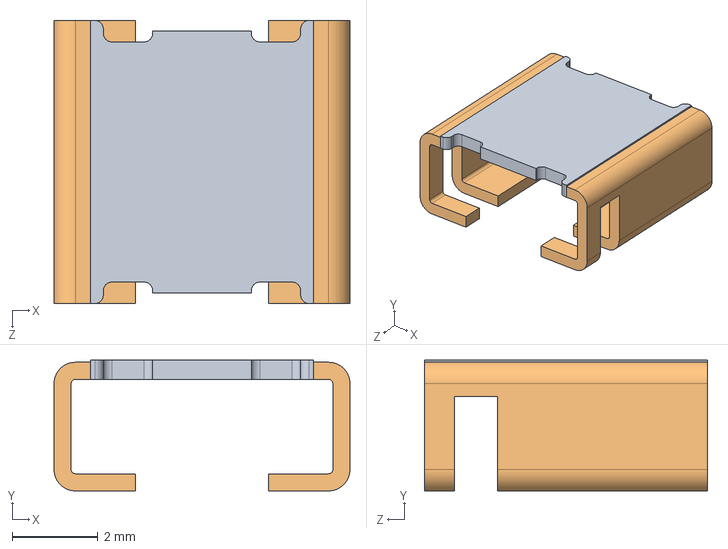
[picture p10: CAD file, 2026-11-05]
hardware/3dmodels/manufacturer/BVB-M-R001-1.0.step
6.90 x 3.05 x 6.60 mm
