feliksdd/panellog/hardware/3dmodels/generated/Spelsberg_12741501_LID_ENVELOPE.step

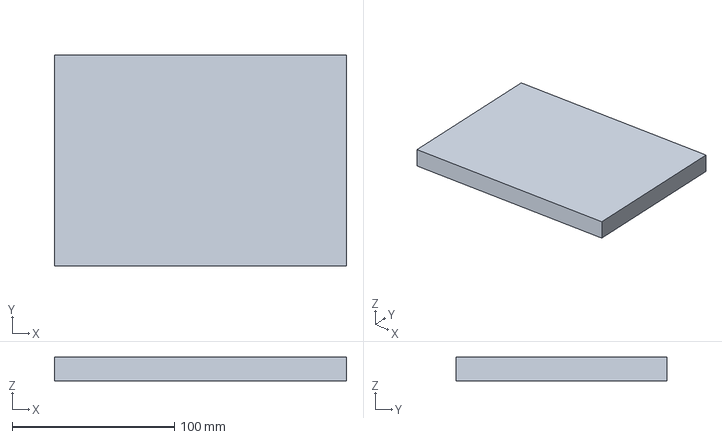
[picture p11: CAD file, 2026-11-03]
hardware/3dmodels/generated/Spelsberg_12741501_LID_ENVELOPE.step
180.0 x 130.0 x 14.5 mm
