feliksdd/panellog/hardware/3dmodels/manufacturer/Kradex_Z74_base.step

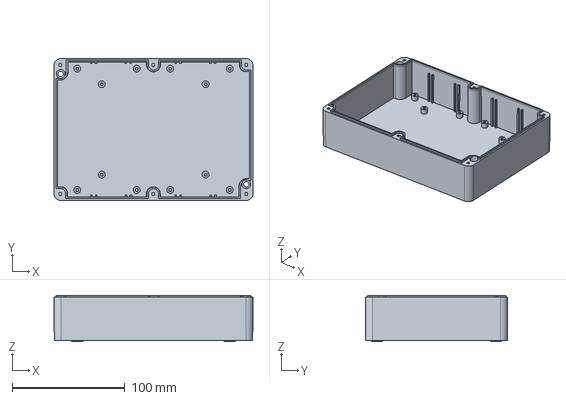
[picture p12: CAD file, 2026-11-05]
hardware/3dmodels/manufacturer/Kradex_Z74_base.step
176.4 x 125.8 x 41.0 mm
