feliksdd/panellog/hardware/3dmodels/generated/Panasonic_F_8x10p2_ENVELOPE.step

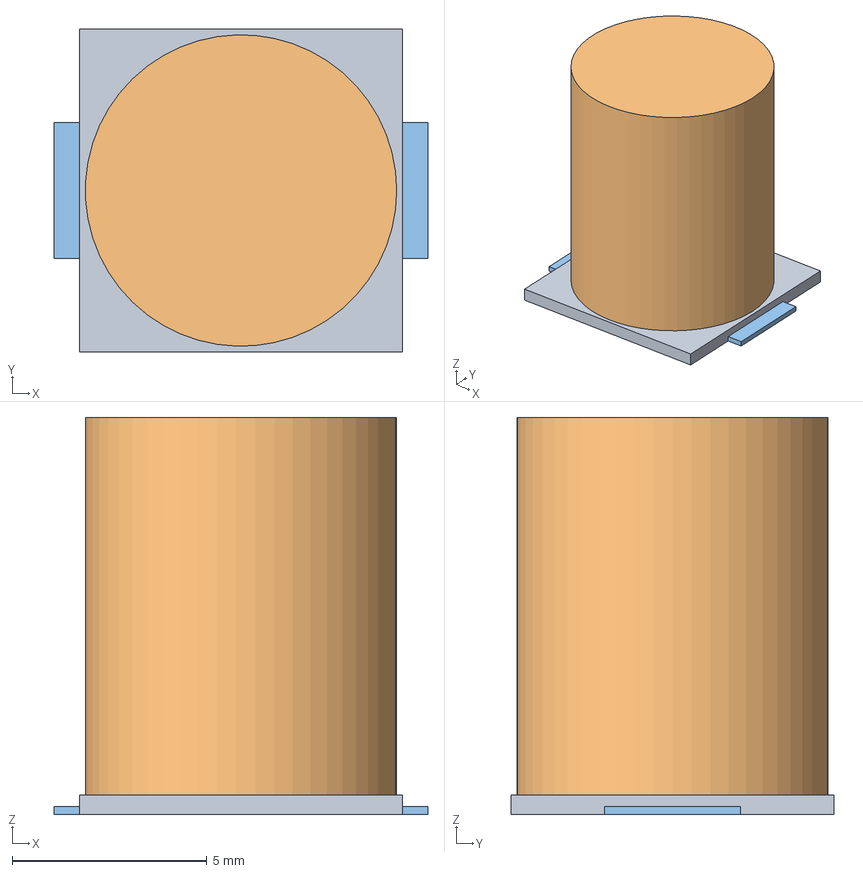
[picture p13: CAD file, 2026-11-03]
hardware/3dmodels/generated/Panasonic_F_8x10p2_ENVELOPE.step
9.60 x 8.30 x 10.2 mm
