feliksdd/panellog/hardware/3dmodels/manufacturer/Kradex_Z74_cover.step

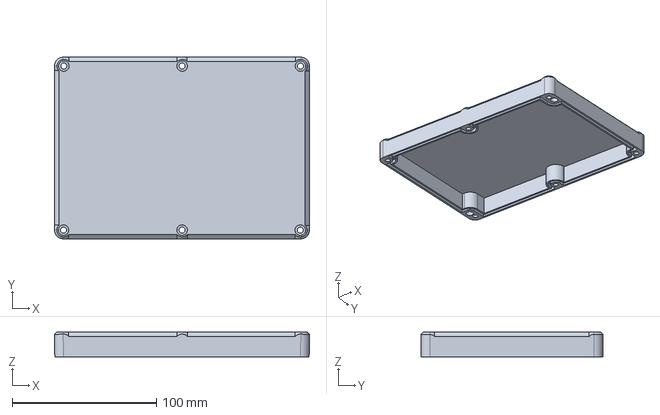
[picture p14: CAD file, 2026-11-05]
hardware/3dmodels/manufacturer/Kradex_Z74_cover.step
176.8 x 126.0 x 17.2 mm
