feliksdd/panellog/hardware/3dmodels/generated/BVB_M_ENVELOPE.step

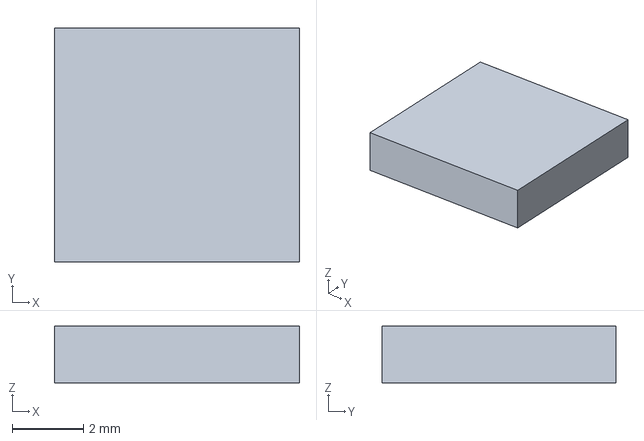
[picture p15: CAD file, 2026-11-03]
hardware/3dmodels/generated/BVB_M_ENVELOPE.step
6.90 x 6.60 x 1.60 mm
