feliksdd/panellog/hardware/3dmodels/manufacturer/Spelsberg_12741501.stp

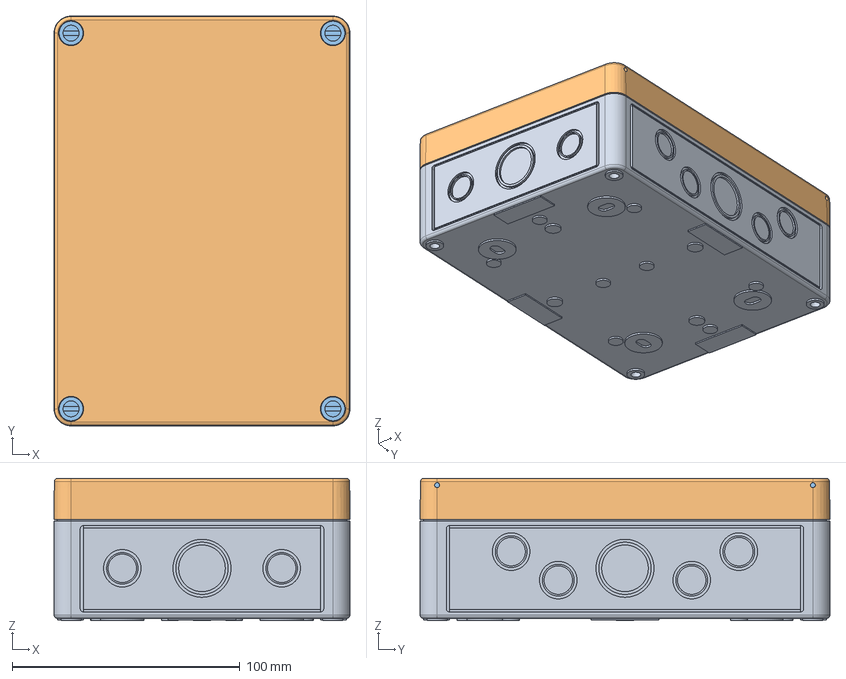
[picture p16: CAD file, 2026-11-04]
hardware/3dmodels/manufacturer/Spelsberg_12741501.stp
130.0 x 180.0 x 62.5 mm
Kasten_TK1813-f-m
Deckel_TK1813-6
Schraube_TK34mm-grau x 4
