feliksdd/panellog/hardware/3dmodels/generated/INA228_DGS10_ENVELOPE.step

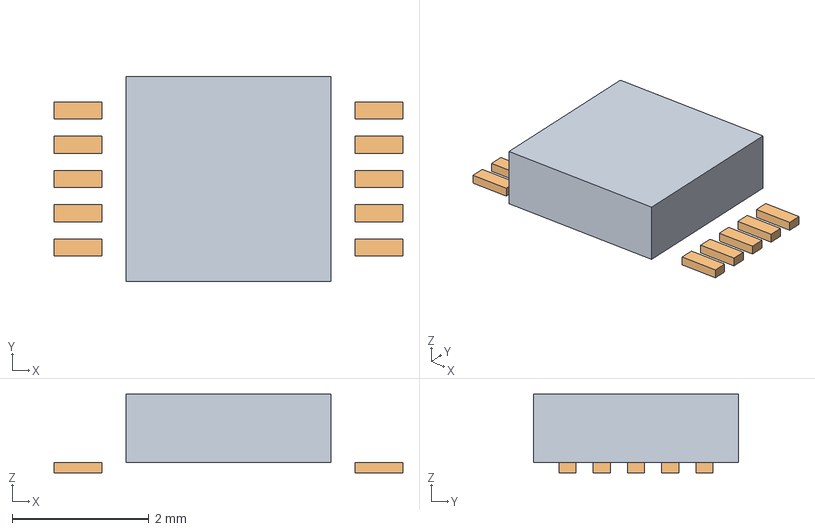
[picture p17: CAD file, 2026-11-03]
hardware/3dmodels/generated/INA228_DGS10_ENVELOPE.step
5.10 x 3.00 x 1.15 mm
