feliksdd/panellog/hardware/3dmodels/generated/Wurth_7447709680_ENVELOPE.step

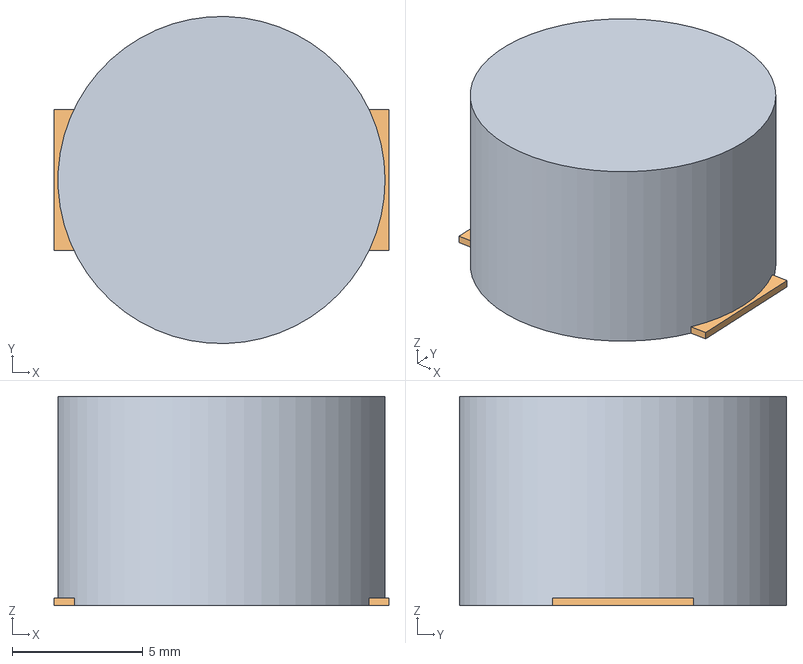
[picture p18: CAD file, 2026-11-03]
hardware/3dmodels/generated/Wurth_7447709680_ENVELOPE.step
12.8 x 12.5 x 8.00 mm
