feliksdd/panellog/hardware/3dmodels/generated/E73_2G4M08S1C_ENVELOPE.step

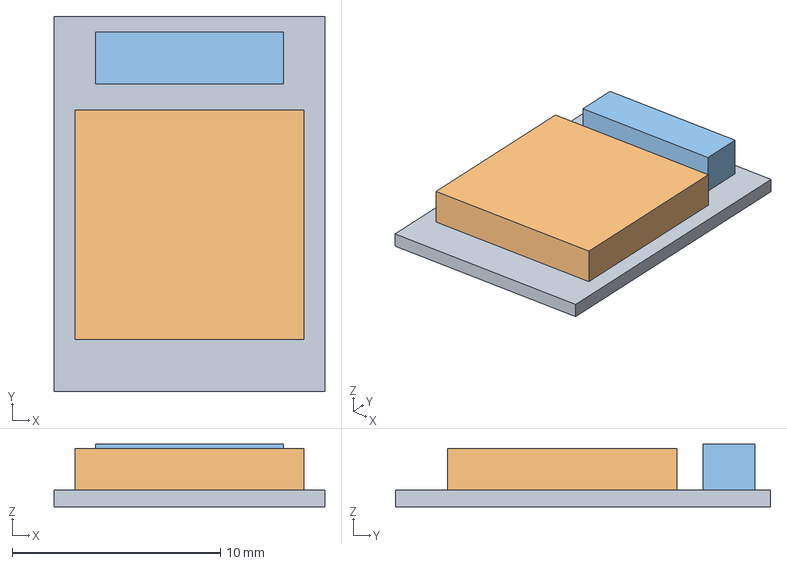
[picture p19: CAD file, 2026-11-03]
hardware/3dmodels/generated/E73_2G4M08S1C_ENVELOPE.step
13.0 x 18.0 x 3.00 mm
