feliksdd/panellog/hardware/3dmodels/generated/LM5164_DDA_ENVELOPE.step

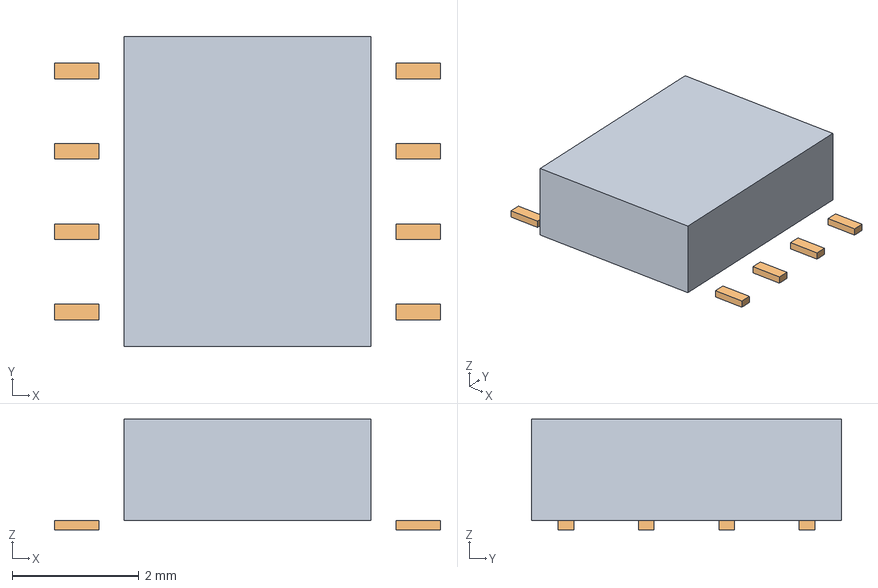
[picture p20: CAD file, 2026-11-03]
hardware/3dmodels/generated/LM5164_DDA_ENVELOPE.step
6.10 x 4.90 x 1.75 mm
