feliksdd/panellog/hardware/3dmodels/generated/Spelsberg_12741501_BASE_ENVELOPE.step

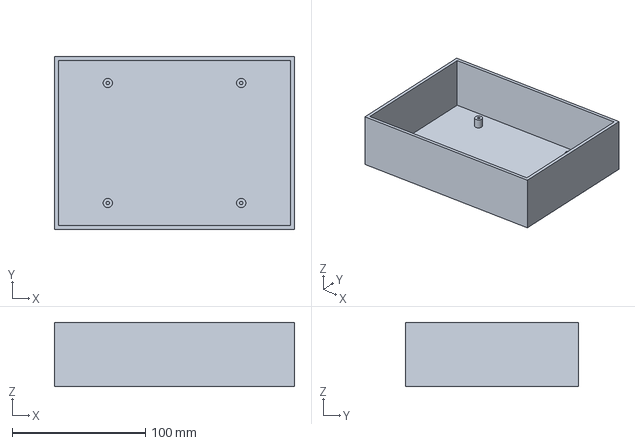
[picture p21: CAD file, 2026-11-03]
hardware/3dmodels/generated/Spelsberg_12741501_BASE_ENVELOPE.step
180.0 x 130.0 x 48.0 mm
