feliksdd/panellog/hardware/3dmodels/generated/PT1000_SOLDER_WIRES_ENVELOPE.step

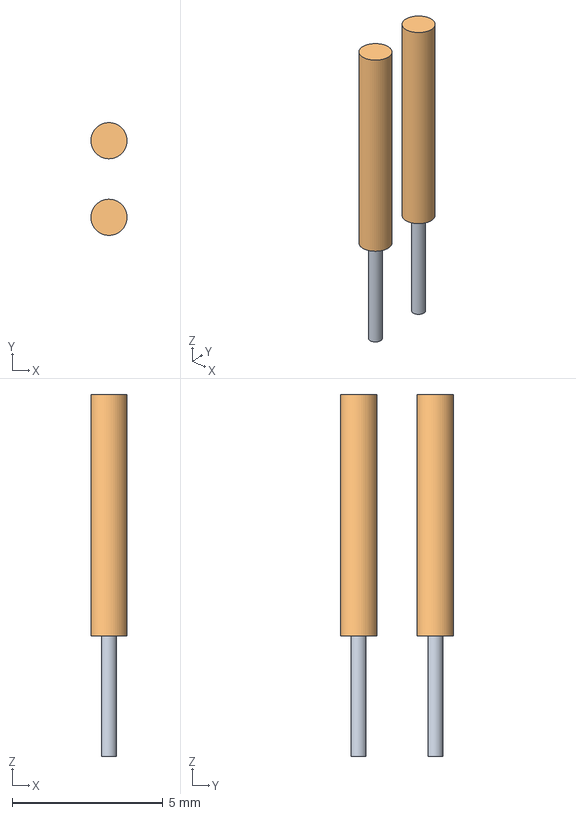
[picture p22: CAD file, 2026-11-03]
hardware/3dmodels/generated/PT1000_SOLDER_WIRES_ENVELOPE.step
1.20 x 3.74 x 12.0 mm
