feliksdd/panellog/(list of files, cad)

Other CAD files:
hardware/mechanical/Z74_2000.dwg
