feliksdd/panellog/hardware/3dmodels/assembly/preview.png

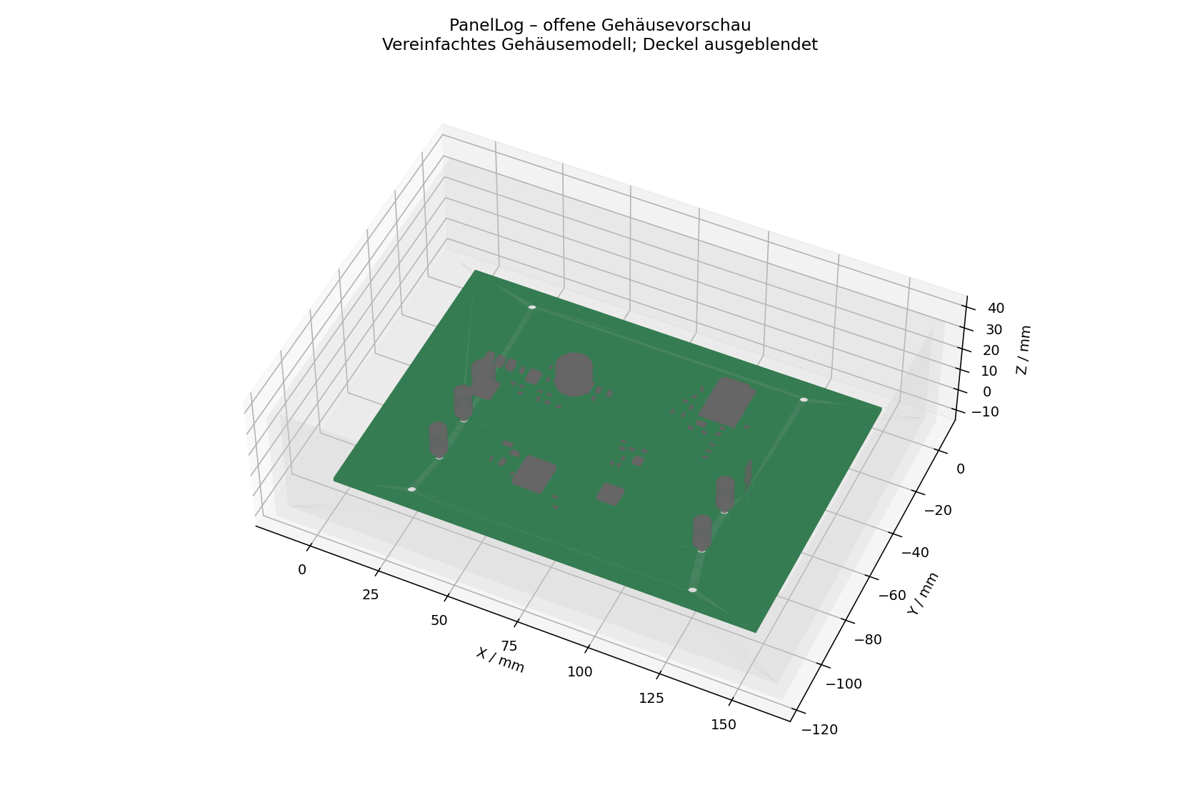
hardware/3dmodels/assembly/preview.png
