feliksdd/panellog/hardware/kicad/panellog.kicad_pcb

## KiCad design hardware/kicad/panellog.kicad_pcb (2026-11-10)

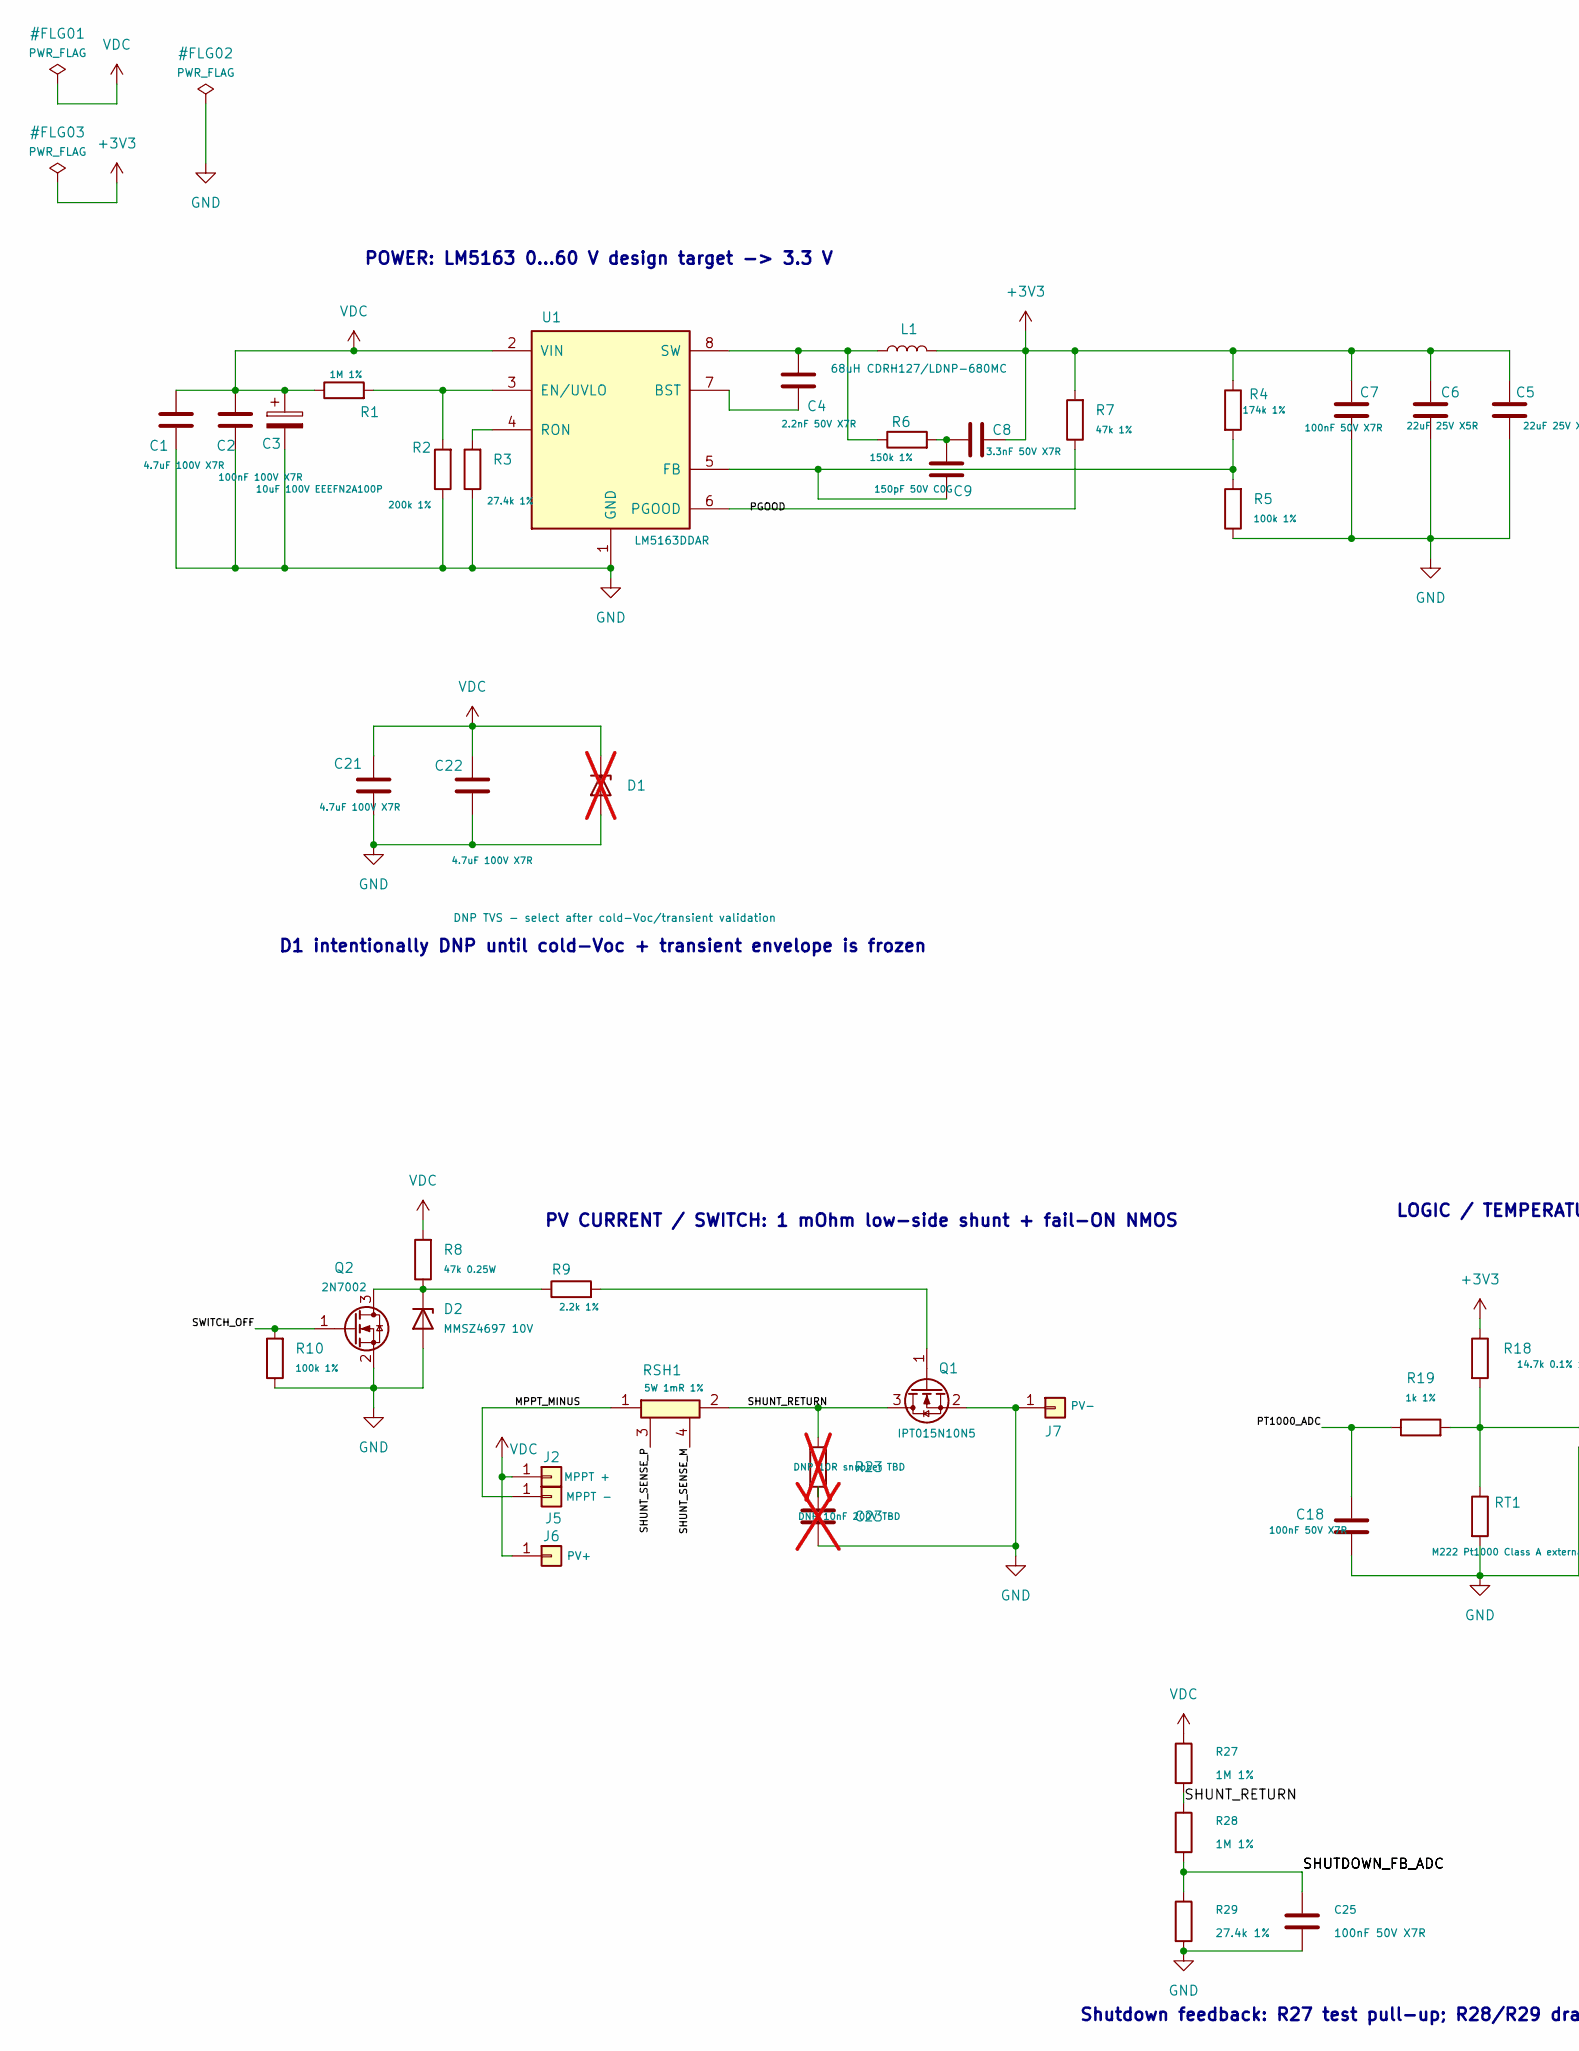
[picture p24: schematic panellog.kicad_sch, PanelLog - PV module logger and curtailment node, part in row 1, column 1]

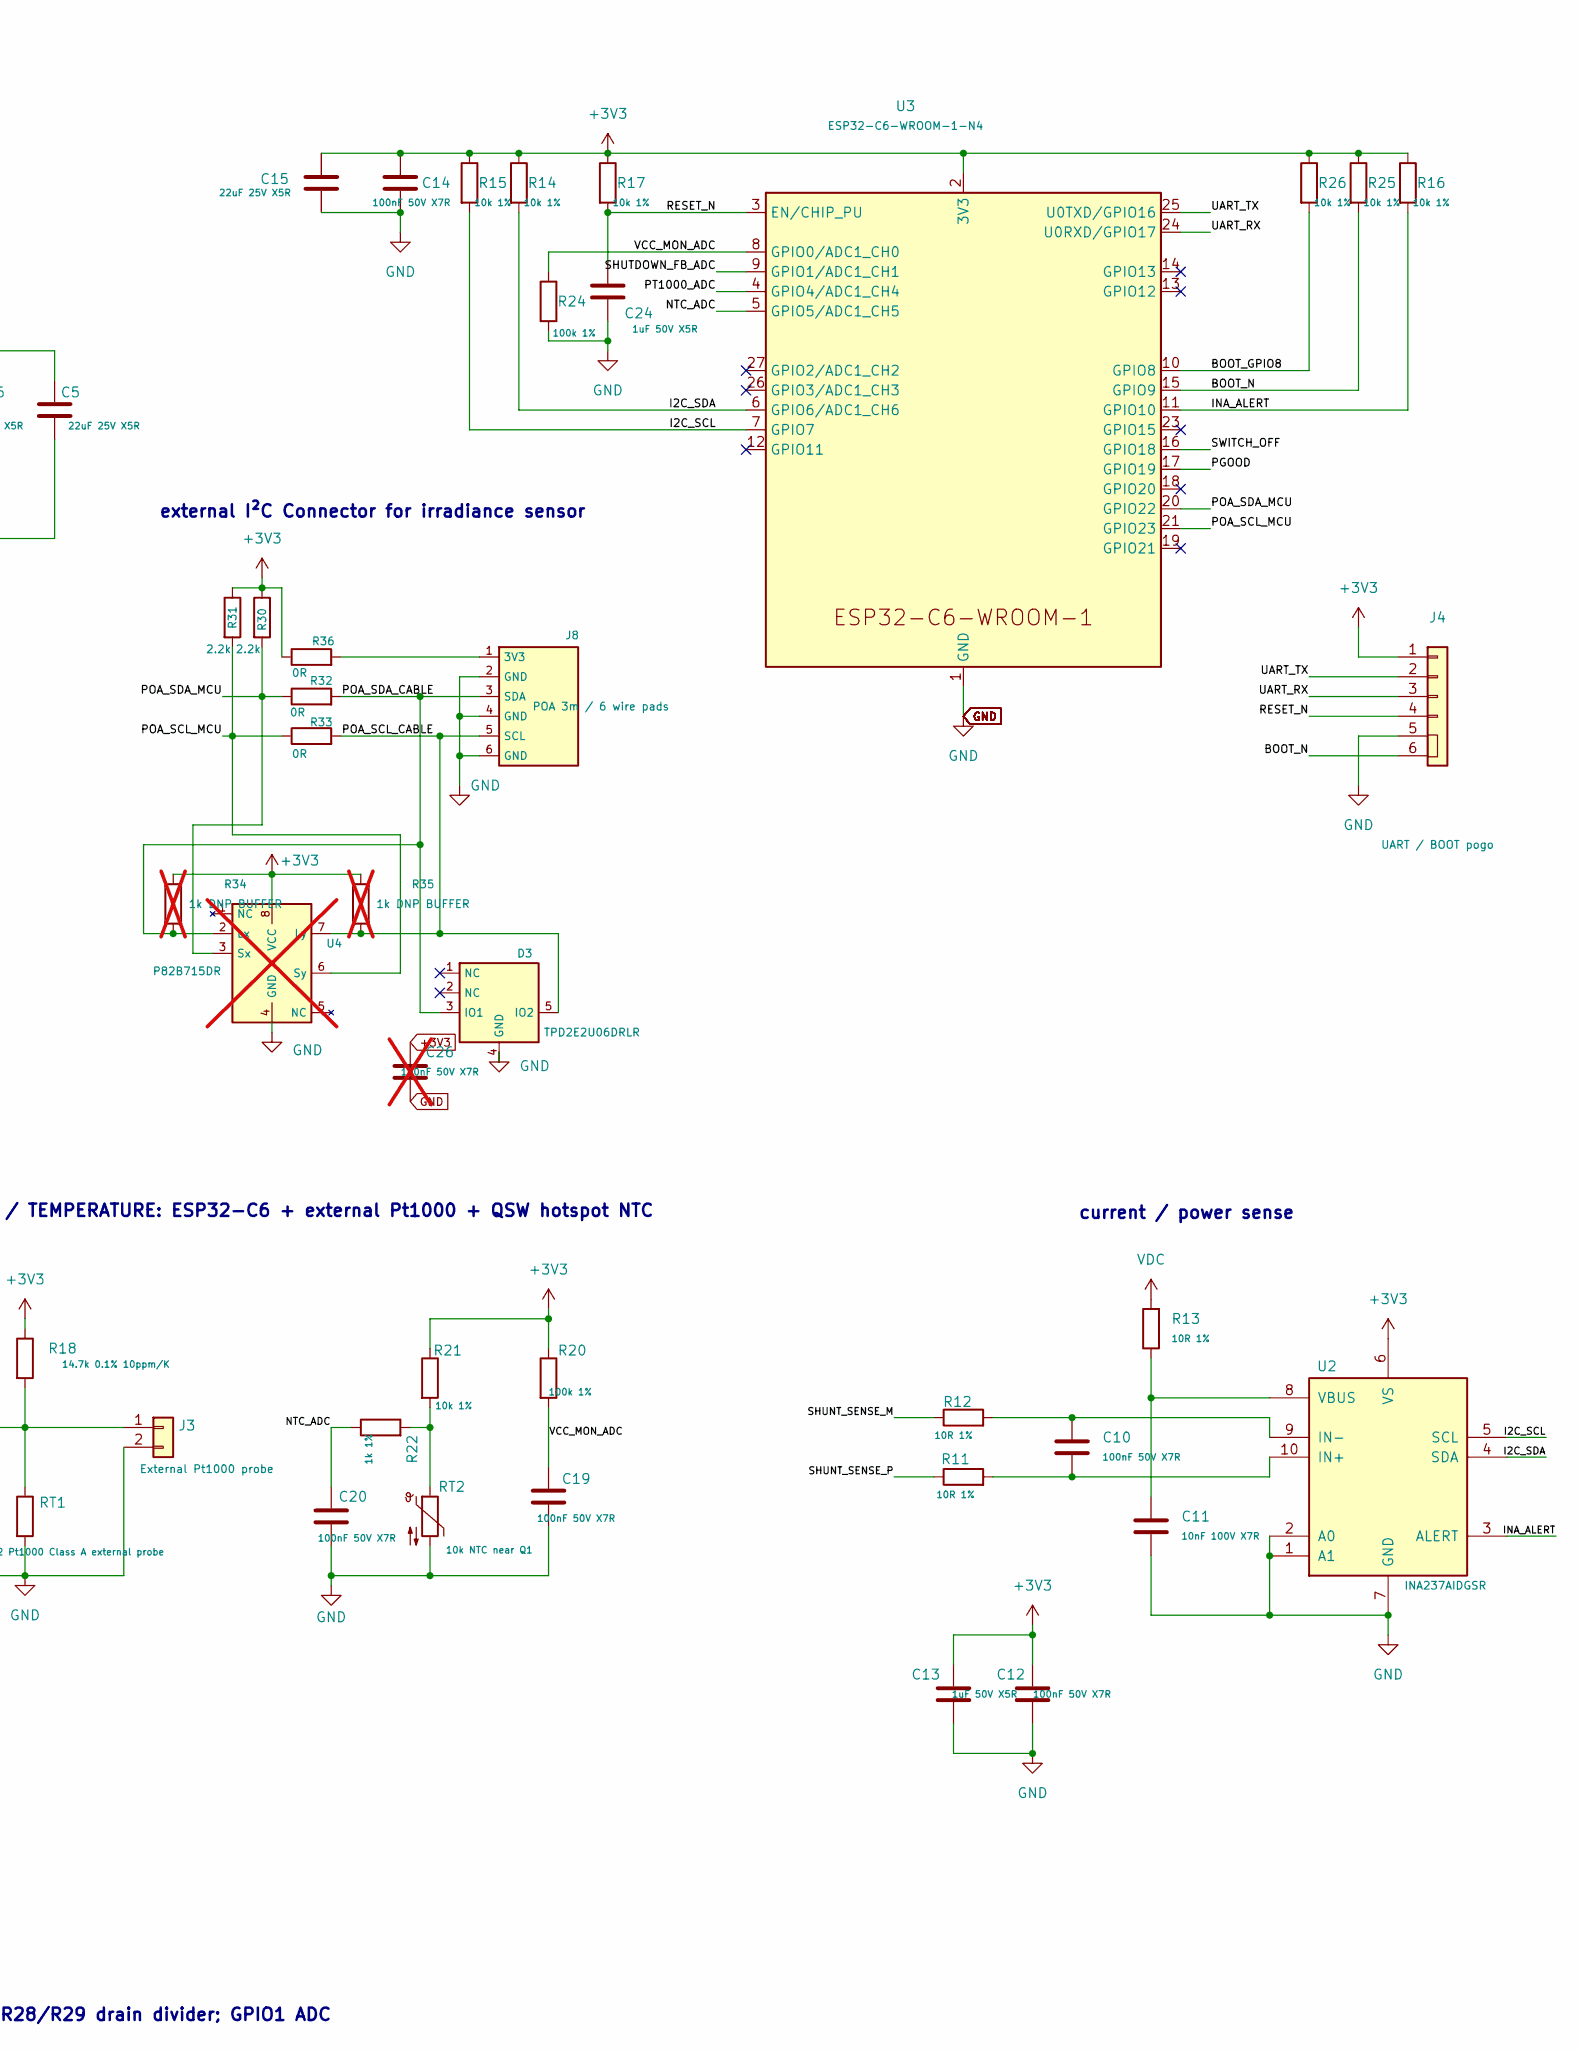
[picture p25: schematic panellog.kicad_sch, PanelLog - PV module logger and curtailment node, part in row 1, column 2]

Parts:
C1, C21, C22: 4.7uF 100V X7R; C_1210_3225Metric; MPN 1210B475K101NT; LCSC C7500895
C2: 100nF 100V X7R; C_0805_2012Metric; MPN CL21B104KCFNNNE; LCSC C28233
C3: 10uF 100V EEEFN2A100P; Panasonic_F_8x10p2; MPN EEEFN2A100P; LCSC C494873
C4: 2.2nF 50V X7R; C_0603_1608Metric; MPN 0603B222K500NT; LCSC C1604
C5, C6, C15: 22uF 25V X5R; C_0805_2012Metric; MPN GRM21BR61E226ME44L; LCSC C86816
C7, C10, C12, C14, C18, C19, C20, C25: 100nF 50V X7R; C_0603_1608Metric; MPN CC0603KRX7R9BB104; LCSC C14663
C8: 3.3nF 50V X7R; C_0603_1608Metric; MPN CL10B332KB8NNNC; LCSC C1613
C9: 150pF 50V C0G; C_0603_1608Metric; MPN CL10C151JB8NNNC; LCSC C37298
C11: 10nF 100V X7R; C_0603_1608Metric; MPN CC0603KRX7R0BB103; LCSC C107059
C13, C24: 1uF 50V X5R; C_0603_1608Metric; MPN CL10A105KB8NNNC; LCSC C15849
C23: DNP 10nF 200V TBD; C_1206_3216Metric; not fitted
C26: 100nF 50V X7R; C_0603_1608Metric; MPN CL10B104KB8NNNC; LCSC C1591; not fitted
D1: DNP TVS - select after cold-Voc/transient validat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; D_SMB; not fitted
D2: MMSZ4697 10V; D_SOD-123; MPN MMSZ4697; LCSC C2910058
D3: TPD2E2U06DRLR; SOT-553; MPN TPD2E2U06DRLR; LCSC C1972959
J2: MPPT +; PV_MC4_Pigtail_2x2p8_DRAFT
J3: External Pt1000 probe; Pt1000_Cable_2pin_DRAFT
J4: UART / BOOT pogo; UART_BOOT_1x06_Pogo
J5: MPPT -; PV_MC4_Pigtail_2x2p8_DRAFT
J6: PV+; PV_MC4_Pigtail_2x2p8_DRAFT
J7: PV-; PV_MC4_Pigtail_2x2p8_DRAFT
J8: POA 3m / 6 wire pads; POA_Cable_6pad
L1: 68uH CDRH127/LDNP-680MC; Sumida_CDRH127_LD_68uH; MPN CDRH127/LDNP-680MC; LCSC C2452974
Q1: IPT015N10N5; IPT015N10N5_TOLL; MPN 2N7002; LCSC C8545
Q2: 2N7002; SOT-23; MPN 2N7002; LCSC C8545
R1: 1M 1%; R_0603_1608Metric; MPN 0603WAF1004T5E; LCSC C22935
R2: 200k 1%; R_0603_1608Metric; MPN 0603WAF2003T5E; LCSC C25811
R3, R29: 27.4k 1%; R_0603_1608Metric; MPN 0603WAF2742T5E; LCSC C22964
R4: 174k 1%; R_0603_1608Metric; MPN 0603WAF1743T5E; LCSC C22890
R5, R10, R20, R24: 100k 1%; R_0603_1608Metric; MPN 0603WAF1003T5E; LCSC C25803
R6: 150k 1%; R_0603_1608Metric; MPN 0603WAF1503T5E; LCSC C22807
R7: 47k 1%; R_0603_1608Metric; MPN 0603WAF4702T5E; LCSC C25819
R8: 47k 0.25W; R_1206_3216Metric; MPN SCR1206F47K; LCSC C5140109
R9: 2.2k 1%; R_0603_1608Metric; MPN 0603WAF2201T5E; LCSC C4190
R11, R12, R13: 10R 1%; R_0603_1608Metric; MPN 0603WAF100JT5E; LCSC C22859
R14, R15, R16, R17, R21, R25, R26: 10k 1%; R_0603_1608Metric; MPN 0603WAF1002T5E; LCSC C25804
R18: 14.7k 0.1% 10ppm/K; R_0603_1608Metric; MPN PTFR0603B14K7N9; LCSC C19680002
R19, R22: 1k 1%; R_0603_1608Metric; MPN 0603WAF1001T5E; LCSC C21190
R23: DNP 10R snubber TBD; R_1206_3216Metric; not fitted
R27, R28: 1M 1%; R_1206_3216Metric; MPN 1206W4F1004T5E; LCSC C17927
R30, R31: 2.2k; R_0603_1608Metric; MPN 0603WAF2201T5E; LCSC C4190
R32, R33, R36: 0R; R_0603_1608Metric; MPN 0603WAF0000T5E; LCSC C21189
R34, R35: 1k DNP BUFFER; R_0603_1608Metric; MPN 0603WAF1001T5E; LCSC C21190; not fitted
RSH1: 5W 1mR 1%; HOVB4026_R001_Kelvin; MPN HOVB4026-5W-1mR-1%; LCSC C481535
RT1: M222 Pt1000 Class A external probe; MPN 32208572; LCSC C17472362
RT2: 10k NTC near Q1; R_0603_1608Metric; MPN NTCG163JF103FT1S; LCSC C406719
U1: LM5163DDAR; LM5164_DDA; MPN LM5163DDAR; LCSC C2873264
U2: INA237AIDGSR; INA237_DGS10; MPN INA237AIDGSR; LCSC C2864837
U3: ESP32-C6-WROOM-1-N4; ESP32_C6_WROOM_1; MPN ESP32-C6-WROOM-1-N4; LCSC C6034714
U4: P82B715DR; SOIC-8_3.9x4.9mm_P1.27mm; MPN P82B715DR; LCSC C2649394; not fitted

Connections:
+3V3: C5.1, C6.1, C7.1, C8.1, C12.1, C13.1, C14.2, C15.1, C26.1, J4.1, L1.2, R4.1, R7.2, R14.1, R15.1, R16.1, R17.1, R18.1, R20.1, R21.1, R25.1, R26.1, R30.1, R31.1, R34.1, R35.1, R36.1, U2.6 (VS), U3.2 (3V3), U4.8 (VCC)
/BOOT_GPIO8: R26.2, U3.10 (GPIO8)
/BOOT_N: J4.6, R25.2, U3.15 (GPIO9)
/I2C_SCL: R15.2, U2.5 (SCL), U3.7 (GPIO7)
/I2C_SDA: R14.2, U2.4 (SDA), U3.6 (GPIO6/ADC1_CH6)
/INA_ALERT: R16.2, U2.3 (ALERT), U3.11 (GPIO10)
/MPPT_MINUS: J5.1 (Pin_1_1), RSH1.1
/NTC_ADC: C20.1, R22.1, U3.5 (GPIO5/ADC1_CH5)
/PGOOD: R7.1, U1.6 (PGOOD), U3.17 (GPIO19)
/POA_SCL_CABLE: D3.5 (IO2), J8.5 (SCL), R33.2, R35.2, U4.7 (Ly)
/POA_SCL_MCU: R31.2, R33.1, U3.21 (GPIO23), U4.6 (Sy)
/POA_SDA_CABLE: D3.3 (IO1), J8.3 (SDA), R32.2, R34.2, U4.2 (Lx)
/POA_SDA_MCU: R30.2, R32.1, U3.20 (GPIO22), U4.3 (Sx)
/PT1000_ADC: C18.1, R19.1, U3.4 (GPIO4/ADC1_CH4)
/RESET_N: C24.1, J4.4, R17.2, U3.3 (EN/CHIP_PU)
/SHUNT_RETURN: Q1.3 (D), R23.1, R27.2, R28.1, RSH1.2
/SHUNT_SENSE_M: R12.1, RSH1.4
/SHUNT_SENSE_P: R11.1, RSH1.3
/SHUTDOWN_FB_ADC: C25.1, R28.2, R29.1, U3.9 (GPIO1/ADC1_CH1)
/SWITCH_OFF: Q2.1 (G), R10.2, U3.16 (GPIO18)
/UART_RX: J4.3, U3.24 (U0RXD/GPIO17)
/UART_TX: J4.2, U3.25 (U0TXD/GPIO16)
/VCC_MON_ADC: C19.1, R20.2, R24.1, U3.8 (GPIO0/ADC1_CH0)
GND: C1.2, C2.2, C3.2, C5.2, C6.2, C7.2, C11.1, C12.2, C13.2, C14.1, C15.2, C18.2, C19.2, C20.2, C21.2, C22.2, C23.2, C24.2, C25.2, C26.2, D1.2 (A), D2.2 (A), D3.4 (GND), J3.2, J4.5, J7.1 (Pin_1_1), J8.2 (GND), J8.4 (GND), J8.6 (GND), Q1.2 (S), Q2.2 (S), R2.1, R3.1, R5.1, R10.1, R24.2, R29.2, RT1.2, RT2.2, U1.1 (GND), U1.9 (EP), U2.1 (A1), U2.2 (A0), U2.7 (GND), U3.1 (GND), U3.28 (GND), U3.29 (GND), U4.4 (GND)
unnamed: C8.2, C9.1, R6.2
unnamed: C23.1, R23.2
unnamed: D2.1 (K), Q2.3 (D), R8.1, R9.1
unnamed: J3.1, R18.2, R19.2, RT1.1
unnamed: J8.1 (3V3), R36.2
unnamed: Q1.1 (G), R9.2
unnamed: R21.2, R22.2, RT2.1
unnamed: C4.1, U1.7 (BST)
unnamed: R1.2, R2.2, U1.3 (EN/UVLO)
unnamed: C9.2, R4.2, R5.2, U1.5 (FB)
unnamed: R3.2, U1.4 (RON)
unnamed: C4.2, L1.1, R6.1, U1.8 (SW)
unnamed: C10.1, R11.2, U2.10 (IN+)
unnamed: C10.2, R12.2, U2.9 (IN-)
unnamed: C11.2, R13.1, U2.8 (VBUS)
VDC: C1.1, C2.1, C3.1, C21.1, C22.1, D1.1 (K), J2.1 (Pin_1_1), J6.1 (Pin_1_1), R1.1, R8.2, R13.2, R27.1, U1.2 (VIN)

Notes on the sheet:
POWER: LM5163 0...60 V design target -> 3.3 V
PV CURRENT / SWITCH: 1 mOhm low-side shunt + fail-ON NMOS
LOGIC / TEMPERATURE: ESP32-C6 + external Pt1000 + QSW hotspot NTC
D1 intentionally DNP until cold-Voc + transient envelope is frozen
Shutdown feedback: R27 test pull-up; R28/R29 drain divider; GPIO1 ADC
external I²C Connector for irradiance sensor
current / power sense

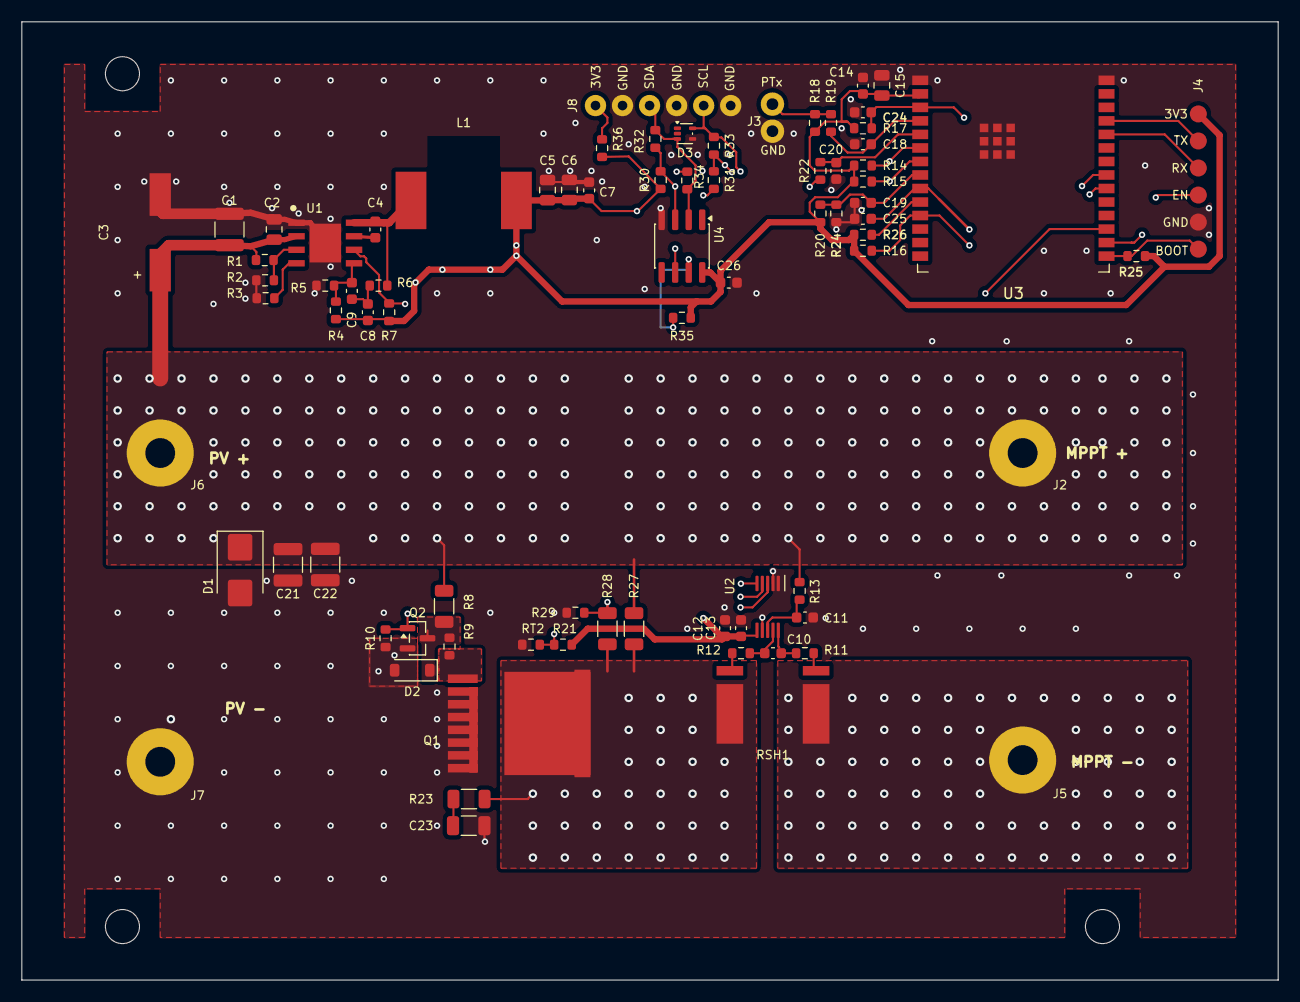
[picture p26: board panellog.kicad_pcb from above]

Board: 4 copper layers, 118.0 x 90.0 mm, 82 parts (0 on the bottom side), 40 nets.

Other parts of the board:
H1, H3, H4: MountingHole_3p2_Nylon
