feliksdd/panellog/firmware/components/poa_soft_i2c/include/poa_soft_i2c.h

#pragma once
#include <stdbool.h>
#include <stdint.h>
#include "esp_err.h"

#ifdef __cplusplus
extern "C" {
#endif

/* Dedicated software I2C; external pull-ups required.
 * Defaults below use GPIO21/22. The WROOM-1 PCB uses GPIO22 (pad 20)
 * for SDA and GPIO23 (pad 21) for SCL; adapt these definitions before use.
 * Not shared with INA237 GPIO6/7. See firmware/README.md. */
#define POA_GPIO_SDA 21
#define POA_GPIO_SCL 22
#define POA_ADS1115_ADDR 0x48

typedef struct {
    float shunt_ohm;         /* calibrated, default 1.0 */
    float current_zero_uv;   /* measured ADC shunt zero at dark */
    float isc_ref_ma_25;     /* individual cell calibration; nominal 58.6 */
    float alpha_isc_per_k;   /* measured Isc temperature coefficient; 0 if unknown */
    float ntc_beta_k;       /* prototype approximation, use R/T table for release */
    float ntc_ref_ohm;      /* divider top resistor, default 47000 */
} poa_calibration_t;

typedef struct {
    float irradiance_w_m2;  /* nominal/uncompensated until reference calibration */
    float reference_cell_temp_c;
    float current_ma;
    float supply_v;
    bool calibrated;
    int64_t timestamp_us;
} poa_sample_t;

/* Initialize independent 25 kHz, open-drain software I2C; idle-high sanity test.
 * On absent/unpowered POA, returns ESP_ERR_NOT_FOUND, never zero irradiance. */
esp_err_t poa_i2c_init(void);
esp_err_t poa_i2c_recover(void);
esp_err_t poa_read_sample(const poa_calibration_t *cal,
                          bool reference_calibrated,
                          poa_sample_t *out);
poa_calibration_t poa_default_calibration(void);

#ifdef __cplusplus
}
#endif
