feliksdd/panellog/(commit log)

2026-10-29 docs: refine calibrated error budget and temperature limits
2026-10-29 bom: add selected PanelLog components
2026-10-29 firmware: document PanelLog control and calibration behavior
2026-10-29 docs: simplify supply, reduce switch loss, revise temperature sensing
2026-10-29 bom: update regulator MOSFET and temperature parts
2026-10-29 hardware: update supply switch and temperature baseline
2026-10-29 hardware: add KiCad 10 schematic source
2026-10-29 hardware: implement KiCad 10 schematic
2026-10-29 docs: align voltage calibration with schematic
2026-10-29 chore: remove temporary KiCad generator workflow
2026-10-29 chore: remove schematic bootstrap source
2026-10-29 hardware: normalize KiCad 10 field serialization
2026-10-29 hardware: normalize KiCad 10 symbol library
2026-10-29 docs: fix 3.3V diagram, feedback value and fail-ON startup
2026-10-29 docs: add PanelLog initial static schematic and module envelope audit
2026-10-29 docs: audit LM5164, gate fail-ON, INA228 and PV transient/current limits
2026-10-29 docs: align bom/README.md with 2026-10-29 electrical audit
2026-10-29 docs: choose sourced C1 and low-current zener candidates for short PV wiring
2026-10-29 docs: align bom/README.md with short-MC4 design decisions
2026-10-29 hardware: implement input capacitor bank and gate components; optional DNP RC snubber
2026-10-29 docs: record source-based KiCad pin/net and DNP validation, ERC pending
2026-10-29 docs: synchronize README.md with native KiCad schematic changes
2026-10-29 docs: synchronize hardware/README.md with native KiCad schematic changes
2026-10-29 docs: synchronize bom/README.md with native KiCad schematic changes
2026-10-29 docs: synchronize docs/design_decisions_short_pv_leads_2026-10-29.md with native KiCad schematic changes
2026-10-29 docs: synchronize docs/electrical_audit_2026-10-29.md with native KiCad schematic changes
2026-10-29 hardware: repair mirrored pin-label mapping and snap KiCad 10 symbols to 50-mil grid
2026-10-29 hardware: register project-local footprint library
2026-10-29 docs: invalidate earlier static validation after real KiCad ERC
2026-10-29 docs: analyze native KiCad ERC and record verified geometric pin remapping
2026-10-29 hardware: add INA228 10-pin DGS local footprint for KiCad 10
2026-10-29 change U2 footprint reference
2026-10-29 hardware: use KiCad standard R/C/L/Zener/2N7002 symbols and add visible local wires
2026-10-29 hardware: convert connectors, NTC, crystal and power flags to standard KiCad symbols
2026-10-29 hardware: route physical local power, shunt, feedback, voltage-sense and crystal connections
2026-10-29 hardware: remove redundant labels on wired local nets
2026-10-29 hardware: add visible gate, INA Kelvin and MCU peripheral wiring
2026-10-29 hardware: mark shared branch junctions on explicit wires
2026-10-29 hardware: remove unused local generic symbol caches from schematic
2026-10-29 docs: capture KiCad 10 standard-symbol and visible-wire conversion validation
2026-10-29 docs: link KiCad 10 standard symbols and wiring audit from hardware README
2026-10-29 Sync KiCad 10 standard symbols
2026-10-29 hardware: add review-stage BVB_M_R0007_Kelvin footprint
2026-10-29 hardware: add review-stage IPT015N10N5_TOLL_DRAFT footprint
2026-10-29 hardware: add review-stage LM5164_DDA_PowerPAD_DRAFT footprint
2026-10-29 hardware: add review-stage PV_MC4_Pigtail_2x2p8_DRAFT footprint
2026-10-29 hardware: add review-stage L_68uH_ENVELOPE_DRAFT footprint
2026-10-29 hardware: add review-stage C_10uF_100V_DAMP_DRAFT footprint
2026-10-29 hardware: add review-stage Pt1000_Cable_2pin_DRAFT footprint
2026-10-29 hardware: add review-stage SWD_1x05_Pogo_DRAFT footprint
2026-10-29 hardware: add review-stage E73_2G4M08S1C_DRAFT footprint
2026-10-29 hardware: assign provisional major-part and cable footprints for PCB placement
2026-10-29 hardware: snapshot pin/net assignments for 61-component PCB placement
2026-10-29 hardware: draft KiCad board with 61 placed footprints, nets and study routes
2026-10-29 docs: review 61-footprint PCB placement, 20A copper blockers and KiCad DRC workflow
2026-10-29 docs: link PCB footprint validation and Rev0 placement draft
2026-10-29 reorderes schematic
2026-10-29 fix power labels and temperature sense circuit
2026-10-29 hardware: restore 11 KiCad footprints lost during schematic re-layout
2026-10-29 hardware: remove 22 duplicate PCB footprints and re-link Y1/RSH1
2026-10-29 hardware: align PCB crystal Y1 pad nets with reorganized schematic
2026-10-29 docs: audit updated schematic logic, temperature sensing and PCB footprint re-linking
2026-10-29 hardware: fix ERC power flags, LM5164 DDA pad shorts, and PCB net aliases
2026-10-29 hardware: fix ERC power-label warnings and synchronize PCB metadata
2026-10-29 hardware: reconcile 18 KiCad10 passives and review all 39 footprints plus 62 BOM items
2026-10-29 hardware: align remaining 10 standard PCB footprints with KiCad 10 libraries
2026-10-29 reorders schematic
2026-11-03 Correct PanelLog footprints and complete prototype routing
    Update schematic, OEM footprints, Kelvin connections, placement and copper routing. Synchronize BOM and add KiCad 10.0.8 ERC/DRC reports and layer previews.
    ERC: 0 errors/warnings. DRC: 0 violations, 0 unconnected items, 0 schematic parity issues under current project rules. Prototype only; thermal and manufacturing verification remain documented.
2026-11-03 Fit PanelLog to Spelsberg TK PC 1813 enclosure
    Set 150x104mm outline and four 3.2mm mounting holes on 100x90mm pattern with copper keepouts. Preserve routed circuit geometry. Document direct-solder PV/Pt1000 wiring, UV-resistant LAPP glands, assembly, cost estimate and physical fit verification.
    KiCad 10.0.8: ERC 0 errors/warnings; DRC 0 violations, 0 unconnected items, 0 schematic parity issues.
2026-11-03 Add local STEP component models and optional enclosure preview
    Vendor nine KiCad standard models with license. Add twelve clearly labelled project-generated simplified envelopes for special components, soldered wires, crystal, and Spelsberg base/lid. Resolve model paths locally, attach hidden enclosure models to H1, and include assembled STEP, preview, inventory, generators and validation.
    All 22 STEP files import as valid solids. KiCad 10.0.8 DRC: 0 violations, 0 unconnected items, 0 schematic parity issues. Envelopes include estimated heights and are not manufacturer-certified collision geometry.
2026-11-04 Align Q1 power return and add stitched top and bottom copper
    Rotate Q1 and align the negative power path horizontally. Add GND and VDC copper on both sides with same-net via stitching; correct gate and temperature-sensor routing while preserving Kelvin sense connections.
    KiCad 10.0.8: zero DRC violations, unconnected items, schematic parity issues and ERC violations. Include reports, copper views and layout notes. Prototype thermal qualification remains open.
2026-11-04 hardware: integrate verified external 3D models on latest routing
    Preserve placement and routing from 130ec6e. Replace generated envelopes with original manufacturer and KiCad package models; document the three missing verified models. Remove stale assembly previews and record structural and STEP validation. ERC/DRC and current assembly export remain pending because KiCad 10 CLI is unavailable.
2026-11-05 Add Kradex Z74 enclosure floor and support outlines to KiCad
    Project the mounting faces and floor of the original Z74_2000.dwg base onto Dwgs.User, centered at (75, 55) mm for fit evaluation. Include the matching millimeter DXF. PCB mounting holes and routing remain as designed.
2026-11-05 Fit PanelLog PCB to the Kradex Z74JH ABS enclosure
    Use the four inner bosses and a 118 x 90 mm outline. Update mounting keepouts, four GND stitching vias and both ground pours. Include the original Kradex ACIS solids and mounting instructions. Retain historical Spelsberg files.
2026-11-05 Mount converted Kradex Z74 base and cover STEP models on the PCB
    Use the original SAT boundary geometry, retain both parts in their common coordinate system, and locate the PCB on the four inner bosses. Document STEP validation, bare-board clearance and the enclosure seam overlap.
2026-11-05 Add supplied E73 and BVB-M STEP models to PanelLog footprints and board
2026-11-05 changes power supply routing and placement
2026-11-05 Route PanelLog on four copper layers with stitched module-current paths
2026-11-05 Move the four-layer VDC current corridor 5 mm away from the return rails
2026-11-06 Add KiCad gitignore rules
2026-11-06 Replace E73 with ESP32-C6 and LM5163; route four-layer cost revision
    Add C6 module, original Espressif model, boot/reset and UART programming interface. Select lower-cost passive MPNs and add four-board procurement BOM. Preserve INA228, BVB 0.7 mOhm shunt, IPT015N10N5 and power-zone geometry.
    KiCad 10.0.8: ERC 0 errors/0 warnings, PCB 0 unconnected, schematic parity 0. Remaining inherited courtyard overlaps and silkscreen/dangling-track warnings are documented; prototype qualification remains required.
2026-11-06 Reduce passive procurement costs and document candidate qualification
    Select VO SCR1206F47K C5140109 for R8 and FH C7500895 for C1/C21/C22. Synchronize both BOMs and schematic/PCB properties. Preserve routing and connectivity. Defer JSCJ 2N7002 and Sumida C2452974 pending missing qualification data.
    Validate KiCad syntax, field parity and exact preservation outside authorized properties. No new native ERC/DRC; historical reports remain unchanged.
2026-11-07 change part placing and resize power planes
2026-11-07 Add low-loss Q1 drain-voltage shutdown feedback on GPIO1
2026-11-07 Regenerate ground and four-layer power-plane stitching
    Publish checked layout and validation reports. Generator script retained in the separate change package pending upload approval.
2026-11-07 Add reproducible plane stitching generator
    Include the approved KiCad Python generator and update its documentation.
2026-11-07 Audit all BOM order codes, availability and MOQ costs; replace unavailable decouplers
2026-11-09 feat(poa): add ESP32-C6 GPIO21/22 software I2C component (poa_soft_i2c.h)
2026-11-09 feat(poa): add ESP32-C6 GPIO21/22 software I2C component (poa_soft_i2c.c)
2026-11-09 feat(poa): add ESP32-C6 GPIO21/22 software I2C component (CMakeLists.txt)
2026-11-09 feat(poa): KiCad schematic GPIO21/22 dedicated I2C, 6-wire header, direct 0R and DNP P82B715
2026-11-09 feat(poa): place optional software-I2C and DNP buffer footprints on PanelLog PCB (routing pending DRC)
2026-11-09 feat(poa): add 6-pad solderable UV sensor-cable footprint
2026-11-09 feat(poa): add low-capacitance TI TPD2E2U06 ESD array to cable interface schematic
2026-11-09 feat(poa): reserve TPD2E2U06 SOT-553 protection footprint at cable entry (routing pending)
2026-11-09 bom(poa): add wired sensor/interface bill of materials and DNP groups
2026-11-09 fix(kicad): move POA library symbol definitions into lib_symbols, restore valid text element
2026-11-09 Add POA connector routing
2026-11-09 Review wired POA hardware: correct KiCad libraries and routing, audit LCSC BOM, add native checks
2026-11-09 Complete DNP P82B715 bypass supply and select precision resistor / Murata capacitor alternatives
2026-11-09 Export native schematic and copper drawings for manufacturing review
2026-11-09 build(jlcpcb): export panelLog_JLCPCB_BOM.csv from frozen PCB BOM source 7f1c67f20ceb
2026-11-09 build(jlcpcb): export panelLog_JLCPCB_CPL.csv from frozen PCB BOM source 7f1c67f20ceb
2026-11-09 build(jlcpcb): export README.md from frozen PCB BOM source 7f1c67f20ceb
2026-11-09 fix(jlcpcb): export panelLog_JLCPCB_BOM.csv, 65 PCB-mounted SMT refs from 7f1c67f20ceb
2026-11-09 fix(jlcpcb): export panelLog_JLCPCB_CPL.csv, 65 PCB-mounted SMT refs from 7f1c67f20ceb
2026-11-09 fix(jlcpcb): export README.md, 65 PCB-mounted SMT refs from 7f1c67f20ceb
2026-11-09 change cpu to ESP32-C6_WROOM
2026-11-09 Synchronize selected LCSC substitutions across board and BOMs
    Align C4, C7/C10/C12/C14/C18/C19/C20/C25, C13/C24 and Q2 with the user-selected articles already present in the schematic. Correct C25 PCB metadata and C13/C24 BOM ratings. Clear stale replacement stock/prices and document the incomplete stock import.
    Validated all 12 references across schematic, PCB and active BOMs; verified the PCB changes only C25 metadata. Native KiCad 10 ERC/DRC not rerun.
2026-11-10 docs: consolidate current circuit design and application guide
2026-11-10 Integrate Kradex drawings and align enclosure models with PCB mounts
