feliksdd/panellog/(notices)

Notices in the files:
hardware/3dmodels/manufacturer/Spelsberg_12741501.stp:
author */ ('License CC BY-ND 4.0'),
